caoc30255-eng/glitchscope/data/README.md

# 数据与参考结果

公开历史扫描摘要位于src/ps/workbench/samples，表示原真实记录的结果副本，不包含完整原始会话。局部波形样例仍明确保留软件推演范围。

私人评审资料中的真实会话保持原内部路径和字节，单独打包，不更名、不回写历史状态。模型训练数据及权重在src/ps/workbench/vendor/edge/data与oss等原目录；推理不自动训练。

人物图及关联恢复图/截图未放公共仓库。使用者可上传自己拥有公开权利的PNG/JPEG/WebP/BMP。当前不凭模型或算法结果替代真实采集，不把软件样例当作板卡测量。
