caoc30255-eng/glitchscope/report/llm_interactions_original/lifecycle_cases/l01.md

# 案例1 明确三板职责与图片主线

阶段：方案设计。本文件为事后导读，不替代原始对话。

## 任务与问题

截至现有记录最早的9月23日，项目已有V1基线，正在讨论波特率偏差和图片演示。单次trial只传1字节，不能直接承担完整图片流；模型一度把STM32设想成图片重组与修复端，偏离原有职责。

## 人工输入与决策

操作者提出通过UART传图、注入毛刺并显示恢复效果，指定PYNQ网页展示，纠正“STM32仅作为真实DUT”，随后明确把图片传输与自动恢复列为主线。

## 反馈与修正过程

模型重新对照工程规格与交接文档，撤回让STM32负责修图的设想，提出分块发送、真实数据回报和PS重组展示的路线；把单字节测试链与图片流需求分开。

## 验证与工程结果

形成了三板职责和新增图片主线的路线说明。该阶段讨论中的选择性重传只是当时的方案设想，不能当作最终实现；后续版本发展为接收数据择优与CRC约束修复，见图片修复案例。

## 适用范围与限制

这里记录的是可恢复历史中的方案演进，不声称恢复了项目最初立项，也不把设计讨论记为硬件验收。

## 原话节选与原消息定位

节选去除Markdown排版；未替换原始消息。

m00073 user 2026-09-23T14:29:52.940000+00:00

> 你有没有阅读项目的工程规格文档 stm32仅作为真实dut

m00074 assistant 2026-09-23T14:30:05.291000+00:00

> 读过工程规格 V1.3，但我上一条把 STM32 当成图片演示的重组与修复端来设计，偏离了“STM32 仅作为真实 DUT”的定位。我会重新对照工程规格和 9 月 23 日交接文档，按平台测试与展示的职责修正方案。

相关消息：m00061、m00069、m00073、m00074、m00075、m00078、m00089、m00091

## 工程证据入口

- formal:docs/project_overview.md

- workspace:release_artifacts/roadmap/full_project_roadmap_2026-09-23.md
