caoc30255-eng/glitchscope/report/llm_interactions_original/lifecycle_cases/p02.md

# 案例6 完善STM32实收回报与短脉冲处理

阶段：开发联调。本文件为事后导读，不替代原始对话。

## 任务与问题

STM32需要报告真实接收字节和状态，不能只回一个成功标志。固件还要处理接收活动、迟到字节及缓冲边界，避免漏采短低脉冲后过早回复OK。

## 人工输入与决策

队友操作者转交验收反馈，要求修订，随后确认新一轮任务是复验既有固件而非重写功能，保留旧版与独立修订版。

## 反馈与修正过程

队友会话记录了v0.2的串口事件缓冲、微秒计时和状态机，再根据反馈在v0.3加入PA10活动锁存、迟到字节、发送前取消和板级记录表；区分资料包、固件与协议版本。

## 验证与工程结果

R103记述ARM构建0错误0警告；R105记述协议167项、事件/ring68695项、活动模型43项断言及构建通过。这些是队友当时的报告，原测试输出未随协作包提供，本轮不将其改写为独立重验。

## 适用范围与限制

队友开发轮次明确未烧录、未改线；不能把离线固件工作当作当时已完成现场验收。STM32始终承担DUT实收与回报，不承担平台选点和图片修复。

## 原话节选与原消息定位

节选去除Markdown排版；未替换原始消息。

peer_R105_M01 user 2026-10-09T09:36:34+00:00

> 我已收到反馈文档，队友B_验收反馈与补证据.md，请查看并修改

相关消息：peer_R103_M01、peer_R103_M06、peer_R105_M01、peer_R105_M06、peer_R108_M01、peer_R108_M02

## 工程证据入口

- peer:附录/对话可见消息与操作索引.json

- peer:来源与整理说明.md
