caoc30255-eng/glitchscope/src/ps/workbench/live_integration.md

# 本版执行入口

请读“board_operations.md”。本版改为本轮父授权＋每任务执行凭据，不再要求操作者逐计划补APPROVED文件。批准动作仍由操作者在界面明确完成；程序只检查范围、保留额度和执行已确认任务。

安装、软件检查、打开网页均不授权任何新试验。此前44条并未获批。安装后需要通过本版目标软件凭据及原资源核对，再由操作者确认本轮范围和额度、逐任务确认启动。
