caoc30255-eng/glitchscope/report/design_report/README.md

# 设计报告

[设计报告](design_report.pdf)，40页，2026年11月4日协作内容补充版。

第7章新增AI建议的采纳与取舍、人工复盘心得，并关联配套Markdown协作记录。目录和页码已更新。当前核验见`../verification/design_report/review_20261104.json`；此前核验文件保留为历史凭据，其哈希不指向当前文件。

报告中的历史封存ZIP及实板会话用于定位原实验；当前仓库部署见`../../docs/first_installation.md`，构建见`../../docs/fresh_reproduction.md`。本次仅更新文档，不新增硬件试验。
