caoc30255-eng/glitchscope/report/llm_interactions_original/README.md

本目录为公开投影：Markdown为当前阅读版，26页PDF作为历史版本保留；Word原稿不随公开仓库分发。案例及来源索引中的本地账户前缀已经匿名化。历史完整原件保留于独立私有评审资料，详见docs/public_release.md。

# 大模型协作记录 当前提交版

- [Markdown当前版](llm_collaboration_with_v1.md)
- [历史PDF版](llm_collaboration_with_v1.pdf)
- [Word编辑版](私有可编辑原稿)

当前Markdown保留22案例，并补充AI协助、人工采纳与未采纳方案及复盘心得。历史PDF为26页、22案例：V1早期6例加后续四阶段16例，历史工作范围为2026年9月8日至11月1日。历史PDF采用宋体黑白排版。

## 来源与索引

v1_cases/和v1_source_map.json记录V1案例及其来源；lifecycle_cases/和lifecycle_source_map.json关联后续16案例。index.json与cases/是主线原文归档的任务索引及原六案例导读，属于来源资料，不是另一版正式阅读文档。

主线原包submission_evidence/llm_interactions_20261101.zip与队友原包teammate_llm_interactions_20261101.zip均保持原样。完整评审资料包为submission_evidence/llm_collaboration_final_20261101.zip，含当前文档、两个原包、V1缓存和日志。

V1有7份有界缓存、35条片段及9份工程资料，不声称早期聊天完整恢复；截断、日期和模型版本缺口按来源保留。主线4750条与队友739条分别统计，不相加当作去重消息总数。

旧8页、19页文档及对应历史发布包已移出当前交付目录，保存在桌面GLITCHSCOPE_历史备份中。原始对话、证据、索引、当前26页全文未删除。设计报告已于2026-11-02完成独立复核并加入report/design_report；本目录保留原始协作记录及当前阅读版。
