caoc30255-eng/glitchscope/docs/design_report_integration_20261102.md

# 设计报告合入记录

2026-11-02按用户要求对自行导出的PDF再次审阅，通过后加入工程。检查覆盖架构职责、三项功能输入与输出、CRC候选及完整性条件、统一d/s排名、实验对照与比例、时钟和资源口径、部署复现及原件索引，并逐页检查39页。

正式入口为`report/design_report/design_report.pdf`，复核凭据为`report/verification/design_report/review_20261102.json`。本次仅修正PDF隐藏Subject中的旧组别标签，未重新排版或修改正文。

根目录README原先将两组配对结果称为局部位错，现按原始审查记录改为B完整帧累计位错，与设计报告一致。

发布清单同步本次文档变更，原始来源清单、硬件会话、通过凭据和旧封存ZIP不重签、不改名。报告第9章中的源码ZIP及SHA仍用于定位之前封存的软件快照。新增含报告工程包与该软件快照分别保留。
