caoc30255-eng/glitchscope/report/llm_interactions_original/llm_collaboration_with_v1.md

# 嵌入式通信容错测评平台大模型协作记录

本记录说明AI在方案设计、开发联调、功能验证和交付复现中提供了哪些帮助，哪些建议被采纳、修改或撤回，以及人工如何依据工程证据作出决定。正文由原有协作资料整理，不是重新生成的聊天实录。

历史案例覆盖2026年9月8日至11月1日，共22例，其中V1早期6例、后续四阶段16例。本版于2026年11月4日整理为Markdown。原消息编号和来源标识继续保留；既有PDF及原始资料不被这次整理改写。

## 1 协作分工与阅读说明

人工确定用途、板卡职责、试验范围与验收要求，进行接线、上电、烧录、板端操作和结果回传。AI协助梳理接口、提出实现方案、编写和审查代码、构造反例、分析日志、组织文档。建议经脚本、仿真、板端运行或原件复核后，才能形成对应范围的结论。

下文把三类内容分开：**采纳或修订后采用**是最终工程处理；**未采纳或撤回**是记录中确有的方案调整；**未作出的结论**是证据范围限制，不冒充一条曾被提出又被否决的建议。早期材料不足以恢复逐轮讨论的地方，保留“未恢复”的状态。

“人工复盘心得”依据已记录的人工纠正、取舍与验证过程浓缩整理，属于事后总结，不作为成员逐字发言。文中的AI开发协助与平台内的边缘AI选点功能是两回事；后者本身还需要独立验证。

## 2 AI协助与人工取舍要点

| 协作问题 | 采取的做法 | 没有采取或撤回的做法 | 判断依据 |
|---|---|---|---|
| 图片功能职责 | STM32保持独立DUT，PS完成重组与修复 | 撤回让STM32承担图片修复的初始设想 | l01，m00073、m00074 |
| 回报长度契约 | 身份、窗口和容量先锁定，长度由回报头派生并以CRC复核 | 修订按请求长度固定登记回报长度的草案 | l02，合法短错误回报反例 |
| 长回复接收 | 依据溢出记录转向原生接收服务并核对调度设置 | 撤回仅靠已有Python/线程优化就已稳定解决的判断 | l05，失败记录与板端压力回传 |
| 统一d/s分析 | 比较本次实际波形的共同有效窗口，整图统一参数 | 未采用上一块反馈预测独立扰动、读取已知注入计划代替接收分析的思路；人工决定此功能不使用AI | l08，m03082至m03893相关记录 |
| 时钟解释 | 核对参考频率、PLL及分频，修正显示值的解释 | 修正直接把PYNQ显示150MHz作为实际工作条件的前提 | l11，7020与AX7010回传 |
| 局部波形候选 | 支持实际N/64个共同窗口，列出未参与块 | 修订只有完整64块才能提供参考的旧规则，不把63写死 | l12，m04701等 |

其他重要处理包括恢复冻结模型原始字节、仅对ARM浮点评分和熵使用有界容差、分别保存新旧SD会话。它们说明人工如何限定修复范围；不据此虚构“AI曾建议取消所有校验”的对话。

## 3 人工复盘心得

**先明确设备职责，再讨论算法。** 模型可能提出功能上可行却偏离项目目标的方案。STM32只承担真实DUT的人工纠正，使平台分析与被测行为保持分离，也避免把修复能力归到被测设备上。

**反例比一段顺畅的解释更有用。** 合法短回报揭示了协议长度假设的冲突；溢出位和原始字节促使接收实现继续改进。请求AI审查时，应同时给出输入、预期、失败原件和约束，而不只描述“运行不正常”。

**先检查前提，再增加实现复杂度。** 时钟问题中，人工提出100MHz的可能性，推动核对参考源和分频。软件读数的单位正确，并不意味着计算前提正确。应先解释现有配置，再决定是否修改RTL或系统。

**修复要对准出错层级。** 换行改变属于发布字节问题，浮点末位差异属于数值兼容问题，现场连线问题需要实物处理。恢复文件、设置有限数值容差、固定接线分别解决不同问题，不能用一个宽松的“通过”条件代替。

**部分有效证据应保留用途，也保留边界。** N/64局部窗口可以支持同窗口候选比较，但不能覆盖缺失块。规则和AI的稀疏选点能减少记录数，仍应同时给出覆盖范围。比较前先统一分母，比给方法贴上“更优”的标签更重要。

**失败记录是下一轮判断的输入。** 新旧卡对照、读回顺序检查和固线后复验形成了定位过程。保留目录、版本、会话身份和失败状态，才能知道改善来自哪里，也能避免把不同轮次的成功拼成一次验收。

**把已验证的方法沉淀为工具，而不是把一次成功泛化成保证。** 跨版本接口适配、冻结文件检查和模型一致性检查可抽成技能。工具的适用设备、输入与验证层级仍需要写明，模型生成的说明本身不构成验证。

## 4 V1基线开发案例

V1部分来自7份有界缓存、35条片段与9份工程资料。材料能够说明阶段设计、失败和交接，但不能恢复全部原始提示词及每次代码修改；以下不为每例补造采纳或否决对话。

### v1_01 共享接收前端与核心验证边界

历史日期：2026-09-08。

**任务与设计决定。** 早期A、B各自同步同一异步输入，可能因两条同步链形成不同的数字观测。9月8日缓存中的日志摘要记载，改为共享两级RX前端，并让接收器使用已同步输入，使算法比较基于同一数字信号。

**开发与协作过程。** 操作者在CRC测试后要求生成工程日志；缓存保留了当日助手整理的共享前端、Trial集成、ABORT/CLEANUP、配置校验和综合路线。该缓存不是完整开发聊天，不能据此补写没有恢复的逐轮代码修改。

**当时记录的结果。** 缓存摘要记载共享前端后重新检查帧间配置锁存和代表性故障条件；9月14日V1.0交接文档随后把UART PHY至结果生命周期列为冻结基线。这两个来源分别表示阶段工作与后续交接，不是本轮重新验证。

**结论边界。** 共享同步链不会消除亚稳态；数字行为回归不能单独证明跨板电气、完整实现时序或后续STM32链路已经通过。V1时A/B位于7010，后续迁到7020的过程见原案例5。

**协作取舍的可恢复程度。** 本例按现存缓存或工程日志陈述已记录处理；未恢复的AI建议、人工否决与逐轮修改不补写。

**来源定位：** cached:v1_20260908_01_02；document:d07。

### v1_02 从控制UART仿真到双板字节回环

历史日期：2026-09-08 至 2026-09-10。

**任务与问题。** 核心仿真通过之后，仍需要真实控制接口把PYNQ与AX7010连接。PHY收发、CRC和完整命令协议不是同一个层级，必须分别建立可观察的验证节点。

**人工反馈与推进。** 9月8日缓存保留CRC测试输出片段；9月9日日志记载首次AX7010 Smoke Test只证明时钟、复位和LED心跳，完整控制协议尚未实测。9月10日再打通PYNQ、AXI UARTLite、物理连线、7010 Echo与返回链。

**可恢复的原始片段。** 9月10日用户缓存原话含“TX 0x00 -> RX 0x00  PASS”，并列出0x55、0xAA、0xFF、0xA5和0x5A全部匹配，最后为“BYTE PATTERN TEST: PASS”。这些是缓存中的用户可见回传，仍保留其不完整性。

**记录结果与范围。** 9月10日工程日志将该轮记为HW-UART-02双板PHY通过。它证明已测试位型的回环，不等于后续Parser、配置、START、结果邮箱和全部异常都在这一天完成。当前整理没有重跑串口。

**协作取舍的可恢复程度。** 本例按现存缓存或工程日志陈述已记录处理；未恢复的AI建议、人工否决与逐轮修改不补写。

**来源定位：** cached:v1_20260908_01_01；cached:v1_20260910_04_01；document:d01；document:log0910。

### v1_03 配置隔离与重复ABORT生命周期修复

历史日期：2026-09-11 至 2026-09-14。

**任务与问题。** 协议必须保证在途配置不被覆盖、重复命令具有确定行为、RESULT_ACK真正清理邮箱。单看收到ACK不足以证明生命周期正确；前置状态错误也不能当作产品失败。

**开发与修正。** 9月11日日志记录Validator正反边界和BUSY期间Apply拒绝。9月12日日志进一步记载repeated ABORT缺陷：中止保持使Guard选到陈旧运行ID，且已有结果阻断幂等ABORT；修复为使用冻结的中止ID，并允许中止锁存态进入幂等路径。

**结果与证据层次。** 9月12日日志记录修复后07C幂等响应与07D清理后重启通过，同时保留08A仅完成前置检查的停点。9月14日缓存则保留第二次RESULT_ACK收到NO_RESULT的用户回传；同日V1.0交接文档记录协议层冻结。

**结论边界。** 本轮核对的是旧缓存和工程日志，不是重新签发当年的RTL、时序或板测结论。9月12日“未完成邮箱验证”和9月14日“协议冻结”是按时间推进的不同状态，不能彼此覆盖。

**协作取舍的可恢复程度。** 本例按现存缓存或工程日志陈述已记录处理；未恢复的AI建议、人工否决与逐轮修改不补写。

**来源定位：** cached:v1_20260911_05_03；cached:v1_20260914_07_03；document:d02；document:d03；document:d07。

### v1_04 十四候选筛选与H2预封存验证

历史日期：2026-09-15 至 2026-09-16。

**任务与问题。** 在14组合法d/s中选择较优配置，不能只挑单个有利坐标。基础25点网格中9组候选并列全通过，需要在同预算下增加有区分力的条件，同时满足正常通信和延迟约束。

**当时的工作路线。** 9月15日日志记录宽毛刺压力切片、多phase压力网格和反向候选顺序重放；协议和接收器RTL保持不变，以testbench推进候选比较。最终在36个去重数字坐标上锁定d4/s-1，增量延迟180ns，满足不超过210ns的约束。

**独立验证记录。** 锁定后、读取结果前封存27个H2坐标及CSV哈希。9月16日日志记载H2-V1中B*为27/27、A为18/27；这些数字对应当时数字验证条件，不是后来STM32实板成功率，也不是当前图片统一参数d4/s-2的证据。

**来源与结论边界。** 本例依据两份现存开发日志；未恢复该阶段完整原始聊天，不把日志改写成逐字对话。H2结果不能回流调参；旧B*只在其冻结条件内成立，不能直接迁到另一块板或另一类载荷上宣布最优。

**协作取舍的可恢复程度。** 本例按现存缓存或工程日志陈述已记录处理；未恢复的AI建议、人工否决与逐轮修改不补写。

**来源定位：** document:d04；document:d05。

### v1_05 Raw Snapshot从参考测试到AXI与BRAM

历史日期：2026-09-16 至 2026-09-17。

**任务与实现。** 7020需要保存真实输入波形，而不是只依赖发送参数。早期按核心采样、同步触发前端、集成、AXI访问、OOC综合，再扩到4096点正式窗口的顺序推进。

**失败反馈与修正。** 9月16日日志记载CAP-01首轮24个错误来自testbench任务之间多出的采样边沿，判INVALID后修正测试台；9月17日CAP-06B首次脚本在不兼容Tcl命令处停止，BRAM已推断也不能把整项记为PASS。

**当时记录的结果。** 正式窗口为2048点Pre、1点触发、2047点Post；验证环形回绕、全逻辑索引和12位AXI地址，保留旧低地址寄存器兼容。日志还记录Block Design接入、完整综合与FCLK BUFG结构修正。

**结论边界。** 9月17日停点仍是板级输入引脚和接线确认，未完成Implementation和实板采样。不能用该日综合WNS或BRAM推断替代后续实际实现；名义100MHz时间换算也要结合后期时钟核对说明阅读。

**协作取舍的可恢复程度。** 本例按现存缓存或工程日志陈述已记录处理；未恢复的AI建议、人工否决与逐轮修改不补写。

**来源定位：** document:d05；document:d06。

### v1_06 首次双板受扰采样与三次重复

历史日期：2026-09-18。

**任务与衔接。** 在采样核心、AXI和构建完成后，V1.1交接把开发推进到双板物理输出、FAULT_MARK触发和PYNQ读回。此时STM32真实DUT仍未开始，不能把这条双FPGA链路写成三板整图功能已完成。

**现存交接记录。** 9月18日文档记载同一受扰条件下A得到0x5D而B*得到0x55；Raw Snapshot保存4096点、触发偏移2048、FAULT_MARK高电平100点，trial9110、9111、9112三次重复一致，Errors为0。

**对后续开发的意义。** 该记录把设定扰动、内部接收差异与板侧数字采样关联起来，形成进入独立STM32阶段的历史基础。后续控制链诊断、接收器迁移、图片流和新卡复现都是在此基础上扩展，而非V1本来就具备的能力。

**来源与结论边界。** 本例仅有现存交接文档作为整理依据，本次没有重新取得这三次采样的全部原始文件。文档中的PYNQ150MHz读回保留为历史描述，并以当前时钟参考审计解释；不能据此宣称真实150MHz签核。

**协作取舍的可恢复程度。** 本例按现存缓存或工程日志陈述已记录处理；未恢复的AI建议、人工否决与逐轮修改不补写。

**来源定位：** document:d08。

## 5 方案设计阶段协作案例

### l01 明确三板职责与图片主线

**问题与原假设。** 截至现有记录最早的9月23日，项目已有V1基线，正在讨论波特率偏差和图片演示。单次trial只传1字节，不能直接承担完整图片流；模型一度把STM32设想成图片重组与修复端，偏离原有职责。

**人工输入与决策。** 操作者提出通过UART传图、注入毛刺并显示恢复效果，指定PYNQ网页展示，纠正“STM32仅作为真实DUT”，随后明确把图片传输与自动恢复列为主线。

**AI协助与采纳后的修订。** 模型重新对照工程规格与交接文档，撤回让STM32负责修图的设想，提出分块发送、真实数据回报和PS重组展示的路线；把单字节测试链与图片流需求分开。

**记录结果。** 形成了三板职责和新增图片主线的路线说明。该阶段讨论中的选择性重传只是当时的方案设想，不能当作最终实现；后续版本发展为接收数据择优与CRC约束修复，见l06。

**未作出的结论与证据范围。** 这里记录的是可恢复历史中的方案演进，不声称恢复了项目最初立项，也不把设计讨论记为硬件验收。

**原消息定位：** m00061、m00069、m00073、m00074、m00075、m00078、m00089、m00091。

**工程证据入口：**

- `formal:docs/project_overview.md`
- `workspace:release_artifacts/roadmap/full_project_roadmap_2026-09-23.md`

### l02 用短回报反例修正图片协议契约

**问题与原假设。** 图片协议草案要求首字节前登记精确回报长度，却又允许STM32报告少于请求长度的实收数据。正常软件回归通过，仍不能排除契约本身的矛盾。

**人工输入与决策。** 操作者将队友交付和反馈带入主线复核。模型核对同版文件与哈希，区分代码修复通过、协议冻结和实板验证三个不同状态。

**AI协助与采纳后的修订。** 构造请求64字节、实际实收为0的合法20字节错误回报：完整CRC与身份可以成立，但按请求长度84字节登记的捕获器把它当作SHORT_FRAME。由此改为先锁定身份、窗口和最大容量，再从回报头派生长度并经完整CRC复核。

**记录结果。** 形成明确的软件反例、修订方向及新版本复验要求。这个案例体现模型协作不仅生成代码，也用于检查接口假设是否相容。

**未作出的结论与证据范围。** 该轮是离线协议与参考模型评审，不代表AXI时钟级行为、RTL或实板已经通过；合法错误回报也不能因业务失败就被当作传输截断丢弃。

**原消息定位：** m00230、m00232、m00245、m00319、m00320。

**工程证据入口：**

- `workspace:release_artifacts/reviews/image_stream_v0_6_3_acceptance_2026-09-29.md`
- `workspace:release_artifacts/design/image_stream_v0_6/contract.md`

## 6 开发联调阶段协作案例

### l03 固化控制链原始字节与溢出诊断

**问题与原假设。** 早期一条试验缺少内部结果，历史现场没有完整控制UART原始字节和错误位，不能仅凭后续正常ACK确定原因。需要先让后续故障可留证。

**人工输入与决策。** 操作者封存正在使用的Notebook，将诊断模块装入同一内核，依次执行正常试验、受控读取停顿与恢复试验，并回传结果。

**AI协助与采纳后的修订。** 模型将临时诊断固化成版本化PYNQ模块，按阶段保存原始收包及状态。受控停顿1.5ms后，trial13023捕获0x22和溢出位0x20；即使STM32载荷正确，该次仍记INVALID。

**记录结果。** 9月24日归档记录确认13022正常、13023异常证据捕获、13024恢复。新增诊断能力没有改写旧网格，也没有把有DUT回报等同于完整事务有效。

**未作出的结论与证据范围。** 这是故障记录与分类能力，不保证Python轮询永不溢出；也不能用新反例倒推出旧缺失记录的唯一根因。

**原消息定位：** m00094、m00107、m00115、m00116、m00117、m00118、m00124。

**工程证据入口：**

- `workspace:release_artifacts/evidence/control_rx_m0/m0_control_rx_acceptance_2026-09-24.md`
- `workspace:release_artifacts/evidence/control_rx_m0/m0_control_rx_acceptance_2026-09-24.json`

### l04 按模块验证波特率偏差与零偏差兼容

**问题与原假设。** 控制协议已定义有符号波特率偏差，但旧Decoder和发送器未完整接入。直接修改共用发送器可能影响控制UART，单字节观察也可能掩盖很小的频偏。

**人工输入与决策。** 操作者按步骤创建RTL与测试台，在Vivado运行隔离仿真并回传PASS和失败信息。模型核对用户创建的文件与实际仿真副本哈希。

**AI协助与采纳后的修订。** 从位时钟、原子配置、Decoder到连续十字节发送器逐层验证。code=0保持旧路径；跨帧累计NCO相位，增加±0.1%、±2%、±8%六点及边界拒绝。再单独检查payload旁路，避免把其他字节送入A/B。

**记录结果。** 隔离发送器的内容、CRC和整帧时钟数匹配参考；payload观察在±0.1%时分别表现为999和1001个时钟。验证从“文件看起来正确”推进到可观察的时序差异。

**未作出的结论与证据范围。** 本案例引用的PASS限于对应隔离模块与测试输入，不能扩写为当时整板、所有故障组合或当前发行固件的完整验收。

**原消息定位：** m00132、m00136、m00151、m00158、m00160、m00162、m00163、m00178。

**工程证据入口：**

- `workspace:release_artifacts/design/faultstim_v2_1/evidence/m1c_frame_tx_acceptance_2026-09-24.md`
- `workspace:release_artifacts/design/faultstim_v2_1/evidence/m1c_payload_tap_acceptance_2026-09-24.md`

### l05 从轮询溢出推进到原生实时接收服务

**问题与原假设。** 长回复超过UARTLite小FIFO的及时服务能力。Python优化、后台线程及共享接收修订后仍有溢出；发送停顿也暴露了Linux调度与命令超时之间的不匹配。

**人工输入与决策。** 操作者回传错误位、FIFO残留、线程权限与板端运行统计，保留失败会话，再编译独立原生库和运行新会话。

**AI协助与采纳后的修订。** 模型依据新增诊断撤回“已稳定解决”的过早判断，先改交易线程共享搬运，再增加CPU亲和性、实时优先级、优先级继承锁与短暂空闲休眠。启动先读回调度设置，失败时不静默降级。

**记录结果。** 10月16日回传1000次远端只读交易全部通过，最大交易内接收服务间隔约0.165ms；随后CONFIG和首个256字节ITEM完成真实回传、核验与严格退役。

**未作出的结论与证据范围。** 普通内存调度验证、只读交易压力与真实ITEM是三个层级；有限压力结果不构成普通Linux永不丢字节的保证。旧溢出会话没有自动恢复。

**原消息定位：** m01346、m01444、m01448、m01519、m01776、m01778、m01779、m01799、m01801、m01803、m01805。

**工程证据入口：**

- `workspace:PS_UART_RT_v5_2026-10-15/README_先读.md`
- `formal:src/ps/native/uartlite_service_v5.c`

### p01 迁移已有接收器并验证7020数字顶层

**问题与原假设。** 队友接手时需要区分重新设计A/B算法与迁移已有实现。旧7010通过的配置不能直接视为7020上的最优参数，隔离模块通过也不等于完整PS系统可运行。

**人工输入与决策。** 队友操作者明确询问是重做还是验证后迁移，并要求先完成数字集成。该需求通过独立队友会话记录，而非主线模型代述。

**AI协助与采纳后的修订。** 队友会话中的模型以7010固定A和可调三点表决B为基线，适配共享CH0同步前端、配置与读回，连接帧关联和Gateway数字发送原型，并单独说明完整Block Design和实体链路边界。

**记录结果。** 队友R021记述Vivado2018.3联合仿真4组场景、309项检查及独立综合通过，覆盖正常发送、A译错后如实转发、选择B和身份受扰拒绝。此次纳入的是可见协作记录，未重新执行该历史仿真。

**未作出的结论与证据范围。** 这是早期单字节数字顶层的迁移过程，不能据此把Gateway实体链路、图片FIFO或最终整机一并标为当时已验收。原F盘源码与完整构建日志不在本次记录包中。

**原消息定位：** peer_R018_M01、peer_R018_M02、peer_R021_M01、peer_R021_M04。

**工程证据入口：**

- `peer:附录/对话可见消息与操作索引.json`
- `peer:完整协作记录.md`

### p02 完善STM32实收回报与短脉冲处理

**问题与原假设。** STM32需要报告真实接收字节和状态，不能只回一个成功标志。固件还要处理接收活动、迟到字节及缓冲边界，避免漏采短低脉冲后过早回复OK。

**人工输入与决策。** 队友操作者转交验收反馈，要求修订，随后确认新一轮任务是复验既有固件而非重写功能，保留旧版与独立修订版。

**AI协助与采纳后的修订。** 队友会话记录了v0.2的串口事件缓冲、微秒计时和状态机，再根据反馈在v0.3加入PA10活动锁存、迟到字节、发送前取消和板级记录表；区分资料包、固件与协议版本。

**记录结果。** R103记述ARM构建0错误0警告；R105记述协议167项、事件/ring68695项、活动模型43项断言及构建通过。这些是队友当时的报告，原测试输出未随协作包提供，本轮不将其改写为独立重验。

**未作出的结论与证据范围。** 队友开发轮次明确未烧录、未改线；不能把离线固件工作当作当时已完成现场验收。STM32始终承担DUT实收与回报，不承担平台选点和图片修复。

**原消息定位：** peer_R103_M01、peer_R103_M06、peer_R105_M01、peer_R105_M06、peer_R108_M01、peer_R108_M02。

**工程证据入口：**

- `peer:附录/对话可见消息与操作索引.json`
- `peer:来源与整理说明.md`

## 7 功能验证阶段协作案例

### l06 用实际受损图片验证CRC约束修复

**问题与原假设。** 图片功能必须先证明展示的是实际接收的坏图，再证明修复来自接收数据计算。不能把发送原图覆盖到结果上，也不能把CRC检错本身说成纠错算法。

**人工输入与决策。** 操作者执行整图会话并交回原件。模型先核验受损图来源，再独立重建修复结果，分列B接收图与STM32回报。

**AI协助与采纳后的修订。** 保留CRC失败的数据，使用块CRC约束搜索及多路接收择优，按整图SHA验证精确恢复。早期方案中的重传设想没有被偷换为已经实现的功能；本次恢复依据保存的接收原件重算。

**记录结果。** 10月19日session27核验记录含65次START、DONE及严格退役，实际毛刺计数8394。单B修复剩483个错误像素，多路融合结果为0且SHA匹配；这是一组有实收来源的功能证据。

**未作出的结论与证据范围。** CRC匹配候选不等于唯一原文，整图SHA一致才支撑该次精确恢复。单张图片通过不代表任意损伤都能修复，也不说明STM32硬件接收本身被调优。

**原消息定位：** m02378、m02379、m02515、m02635、m02636。

**工程证据入口：**

- `workspace:release_artifacts/reviews/random_image_session_00000024_2026-10-18/核验结论.md`
- `formal:report/verification/workbench_repair/repair_delivery_review.json`
- `formal:report/verification/workbench_repair/actual_raw_contract.json`

### l07 从模拟网格走到真实容错热力图

**问题与原假设。** 界面能显示14格或模型流程完成，不代表硬件边界已经测出。还需要区分B整帧正确、STM载荷正确与STM业务成功。

**人工输入与决策。** 操作者按受控计划执行新会话并提供完整证据。模型先在软件层验证预算、异常停止与原件篡改拒绝，再检查板端记录。

**AI协助与采纳后的修订。** 计划采用CONFIG与无扰动参照各1条、14格各3次，共44条。逐条核对参数读回、42次毛刺快照、原始接收结果和退役证明，再独立重算三类统计。

**记录结果。** 10月20日session29的44条完成严格退役，无UNKNOWN；三类统计与网页一致。B在相位15、宽度10出现2/3正确，STM某些格点载荷正确却业务失败，证实不能合并判据。

**未作出的结论与证据范围。** 每格3次属于粗扫描，混合结果需要保留；少量重复不是确定边界或普遍概率保证。44条是这份配置的计算结果，不是所有扫描的固定条数。

**原消息定位：** m02561、m02640、m02642、m02643、m02701、m02703、m02705、m02706。

**工程证据入口：**

- `workspace:release_artifacts/reviews/session29_real_scan_2026-10-20/核验结论与下一步.md`
- `workspace:STM_B_Real_Heatmaps_Baseline_2026-10-21/实测基准报告.md`
- `formal:report/verification/scan_backend/owner_review.json`

### l08 把参数推荐限定为同波形的可验证比较

**问题与原假设。** 模型先后提出利用上一块反馈或已知毛刺计划选参，但独立随机扰动不能由上一块预测，读取注入计划也不符合未知干扰接收的目标。局部快照又不等于完整帧波形。

**人工输入与决策。** 操作者要求分析本次实际波形，明确采用软件推演，并决定第三功能不使用AI。后续统一参数用于64块，不允许每块各取一组d/s。

**AI协助与采纳后的修订。** 转向与B接收器一致的逐周期软件模型，保留初相歧义，比较同一组有效窗口中的14组d/s。31段早期波形中21段一致、10段不确定，没有用目标答案反选初相；再由操作者运行RTL对照。

**记录结果。** 10月22日回传1125用例、11389950周期对照通过。后续两张图片四组260条独立配对验收中，统一d4/s-2相较基线减少位错约30.3%和35.4%，保留具体条件与原件关联。

**未作出的结论与证据范围。** 模型与RTL一致不能补回采集时缺失的内部初相；软件候选、局部范围和重新实测的参数效果分层报告，不宣称全条件最优，也不改写原接收数据。

**原消息定位：** m03082、m03086、m03158、m03162、m03163、m03165、m03171、m03201、m03202、m03893。

**工程证据入口：**

- `formal:src/ps/workbench/vendor/ds/rtl_cosim_receipt.json`
- `formal:report/verification/ds_analysis/owner_acceptance.json`

### l09 验收边缘AI的运行闭环与选点范围

**问题与原假设。** 模型能推理、跨平台输出一致、闭环能选点，以及是否比规则更省试次，是不同的验证问题。不能把开源组件接入或软件测试通过直接等同于扫描提效。

**人工输入与决策。** 操作者要求覆盖自选配置，执行ARM软件检查与三组实板对照，交回失败和修复后的报告。模型根据这些结果限定已学习范围和回退规则。

**AI协助与采纳后的修订。** 对ARM浮点末位误差，只给score与entropy指定1e-12绝对容差，类别、动作和权限严格比较，模型权重不改；45条黄金查询和450条C对照通过。随后按14条规则、14条AI、44条参照执行有界对照。

**记录结果。** 三组共72条流程完成；规则和AI各测4格，均触及新参照6个边界格点中的2格，主要覆盖指标持平。项目保留二者作为减少选点的并列策略，不要求AI优于规则才允许使用。

**未作出的结论与证据范围。** 本轮确认推理、选点、反馈与证据链可运行，不支持AI普遍更快、更准或所有自选条件均经实板验证。完整14格图来自参照组，不能将稀疏选点展示成全网格实测。

**原消息定位：** m03904、m03908、m03913、m03962、m03964、m03966、m03990、m03994、m03995、m03996、m03997。

**工程证据入口：**

- `formal:report/verification/edgeai_arm/owner_review.json`
- `formal:report/verification/edgeai/owner_final_comparison.json`
- `formal:docs/selection_methods.md`

## 8 交付复现阶段协作案例

### l10 把外部评审转化为Skill缺陷修订

**问题与原假设。** 86项原测试通过后，另一次上下文评审仍发现零掩码身份校验、时钟副作用记录、混合寄存器字段语义和新仿真示例闭环不足。

**人工输入与决策。** 操作者将评审意见带回主线并要求集中修订。模型逐项核对并复现，不把外部评分当作自动证明，也不直接把评审文字当作实现要求。

**AI协助与采纳后的修订。** 补零掩码拒绝、HWH地址核对、字段级访问语义、流式哈希与Python/C示例，运行新RTL示例及负向验证，并区分真实适配和合成测试范围。

**记录结果。** 修订与验证资料进入正式Skill目录；随后加入时钟审计能力，当前归档保留195项回归和各阶段原件。评审推动了实现与自动检查，而不仅是说明文字扩充。

**未作出的结论与证据范围。** 独立评审会话同样属于模型协作，不冒充人类评委意见。回归测试、现场跨板结论和具备原始日志的实测分别记录来源。

**原消息定位：** m04298、m04299、m04300、m04301、m04303、m04304、m04305。

**工程证据入口：**

- `formal:skill/verification/current_summary.json`
- `formal:skill/verification/current_unit_report.json`
- `formal:skill/verification/cross_board_experiment.json`

### l11 核对名义频率与板载参考时钟

**问题与原假设。** PYNQ显示FCLK0为150MHz，但150MHz时序签核没有通过。若不核对参考频率，可能把软件计算读回误当成实际配置频率。

**人工输入与决策。** 操作者提出实际可能仍为100MHz，并回传7020只读寄存器、设备树及AX7010的PYNQ2.4环境结果。

**AI协助与采纳后的修订。** 模型转向检查PYNQ的50MHz参考假设与板侧约33.333333MHz声明，结合PLL倍频30和两级分频5、2推导；同时修复采集器对旧版类方法接口的兼容性。

**记录结果。** 配置推导支持当前FCLK0约100MHz；正式文档区分PYNQ名义150读回与参考加寄存器推导。没有仅为读数名称修改setter或制造150MHz签核通过结论。

**未作出的结论与证据范围。** 这是参考与配置一致性审计。当前发行说明依据实际交付范围和100MHz时序结果，不将软件读回当作完整硬件身份或频率证明。

**原消息定位：** m04343、m04362、m04363、m04400、m04422、m04423。

**工程证据入口：**

- `formal:docs/clock_reference.md`
- `formal:report/verification/clock_reference/board_readonly_excerpt.json`
- `formal:skill/pynq-clock-reference-audit/SKILL.md`

### l12 修复冻结文件并保留部分证据的用途

**问题与原假设。** 工作台分析在FROZEN_CYCLE_MODEL_CHANGED处被拦截；恢复原模型后，另有1块局部波形无法对齐，原全64规则不能给出完整候选。两类问题需要分别处理。

**人工输入与决策。** 操作者提供报错包，要求修复网页，并进一步要求局部参考支持任意实际有效数量，不能写死63块；同时指定覆盖率、未参与块与大字号提示。

**AI协助与采纳后的修订。** 模型对照原冻结凭据，发现CRLF/LF换行差异，恢复原字节而不改凭据绕过。随后新增共同有效窗口比较：14组候选使用同一组窗口，局部参考与全64候选分开。

**记录结果。** 模型哈希重新匹配既有RTL凭据，网页与worker链路恢复。有效窗口1至64块可给局部参考；0块或完整性、模型矛盾时不出候选，界面明确列出N/64覆盖和未参与块。

**未作出的结论与证据范围。** 局部参考不覆盖未评估块，不代表整图最优或推荐参数已实板验证。修复打包字节与解释数据覆盖范围，不等于放宽采集真实性校验。

**原消息定位：** m04684、m04686、m04688、m04689、m04699、m04701、m04702、m04706、m04707。

**工程证据入口：**

- `formal:src/ps/workbench/tests_ds_frozen_model.py`
- `formal:src/ps/workbench/vendor/ds/tests_local_reference.py`
- `formal:docs/ui_update_20261101.md`

### l13 备用SD冷启动与真实记录复现

**问题与原假设。** 已有安装能够运行不能代替干净环境首次部署。备用卡复现还出现图片波形异常，必须区分源码迁移、运行环境、采集读回和现场连接等可能原因。

**人工输入与决策。** 操作者从备用7020镜像启动，执行软件复现、编译原生库及0历史初始化，提供新旧卡对照、快照和最终成功会话；现场重新固定接线。

**AI协助与采纳后的修订。** 模型保留失败会话与UNKNOWN，核对多次读回和旧卡复现，撤回仅凭新卡或相位解释问题的判断。固线后重新核验未放宽的波形校验，再把通过的分支与部署说明合入发行包。

**记录结果。** fresh_runs/session7完整原件3067文件归档核验，65条严格退役、64份毛刺波形检查通过；多路CRC修复整图SHA一致，64/64局部窗口在ARM完成分析，统一软件候选d4/s-2。初始会话、试验记录与额度均为0。

**未作出的结论与证据范围。** 备用卡现场启动与初始化来自操作者回传，session7原件单独核验；不把旧卡成功冒充fresh_runs。固线后的成功支持现场判断，但不能扩写成独立电气因果测量；该次软件候选也不等于所有条件最优。

**原消息定位：** m04567、m04568、m04574、m04576、m04577、m04626、m04673、m04676、m04720。

**工程证据入口：**

- `formal:docs/first_installation.md`
- `formal:docs/fresh_sd_acceptance_20261101.md`
- `formal:report/verification/ui_software/fresh_sd_session7_20261101.json`

### p03 从UI审批原型到可演示的交互要求

**问题与原假设。** 功能后端与演示界面由不同工作线推进，不能把独立UI演示当作已经连通硬件的工作台。初版图片滑块固定两侧来源，也不满足自由比较要求。

**人工输入与决策。** 队友操作者传达完整三功能设计要求，转交左右自由选图反馈，又要求三条波形作为主要演示。主线随后提出导航字号、AI并入扫描和d/s页样式统一的修改。

**AI协助与采纳后的修订。** 队友原型补左右独立选图、交换、滑块位置、差异重算与软件重建曲线，按新版本保留；主线接手后继续做服务接口与原生d/s视图的集成检查。

**记录结果。** R175至R178可追溯7页审批稿、自由选图修订、三波形与展示版迭代；主线m04019记录UI代码与接口检查。两条记录共同说明设计输入、反馈、修订到集成的交接，而非一个模型独自完成所有环节。

**未作出的结论与证据范围。** 队友原型数据标为UI演示、未接硬件；主线软件集成也不替代后续实板验收。绿色曲线为软件重建，不称为再次实际发送的电气波形。

**原消息定位：** peer_R175_M01、peer_R175_M09、peer_R176_M01、peer_R176_M05、peer_R177_M01、peer_R177_M05、peer_R178_M12、m04013、m04019。

**工程证据入口：**

- `peer:附录/对话可见消息与操作索引.json`
- `formal:src/ps/workbench/verification_record.json`

## 9 来源范围与复核方法

原主线索引为4750条可见用户与助手消息，工具事件另存；协作方资料另列2条对话、179轮、739条可见消息。两路统计不相加冒充去重后的消息总数。没有记录的模型型号、提示词或时间不作补填。

本记录沿用工程目录`report/llm_interactions_original/`中的`v1_source_map.json`、`lifecycle_source_map.json`及案例导读。`m`编号对应主线原消息，`peer_R…_M…`对应协作方轮次与消息；`cached:`与`document:`标识V1缓存及工程文件。原始消息和完整附件按既有独立评审资料归档，不因Markdown正文中的定位编号而被视为已全部公开。

证据入口的`formal:`表示正式工程相对位置，`workspace:`表示历史工作区资料，`peer:`表示协作方原包内位置；这些是来源标识，并非本Markdown所在目录下可以直接点击的路径。定位时先查相应来源索引，再核对原件及其适用版本。

复核应从具体主张出发：先定位案例和原消息，区分当时建议与后来实现，再查该轮验证原件。软件测试、RTL仿真、实现时序、现场试验和事后文档整理分别表达，不能相互替代。本次格式改写没有新增硬件试验，也没有重新签发历史验收结论。
