caoc30255-eng/glitchscope/build/reports/ax7010/readme_candidate.md

# v0.12 多点毛刺工程候选比特流

按用户明确要求，在网表仿真继续期间直接生成候选bit。不是整套多点功能或硬件已验收。

源为route12_1792249299054/routed_mp12.dcp，SHA256 b42592c158c2ef9a7c07047488231fa912e318a35fc92430dd1041a45efce793。已声明约束下WNS+0.228ns、WHS+0.013ns，建立/保持失败0，16项总线偏斜最小余量+8.936ns，30184条网络全部布通，47个BRAM寄存器配置未改变。4400/4400 Slice。

功能：Direct ITEM连续1..256载荷字节，每字节一个相同bit/phase/width的毛刺。旧TYPE3A单点/禁用语义保留，新TYPE3C/ACK7C用于范围配置；CH2只标记首个毛刺，新MPG1寄存器提供点数/身份读回。7020短快照不能当作全部毛刺的波形证明。

已通过组件、复位黄金对照和49帧全板控制RTL仿真。功能网表回归、多点H1上传→START完整生命周期、PS实时多点准入/计数证据适配、真实STM32及多点实板对照仍待完成。现有PS单点执行器不会自动变为多点执行器，不应直接填入新类型并称实板通过。

这是7010纯PL bit，不含7020 HWH/Overlay或STM32程序。原8根顶层端口、引脚、电平、50/100MHz时钟约束未变；W19仍同时送到STM32和7020 CH0。

导出只写新exports/candidate12_*目录，不优化、不重新布局布线、不修改DRC严重性、不连接JTAG或下载板卡。原v0.10可用bit、v0.11失败DCP和v0.12实现DCP都保留。部署和下一组试验应使用新会话、明确已加载版本及既定复位流程，不恢复历史UNKNOWN在途记录。
