caoc30255-eng/glitchscope/report/llm_interactions_original/cases/case03_frozen_model_newlines.md

# 冻结模型哈希失败：恢复原字节，而非改凭据绕过

本文件为事后整理的案例导读，不是重写后的原始对话。原始消息编号可在独立评审记录包中定位。

## 问题

网页分析在FROZEN_CYCLE_MODEL_CHANGED处被拦截。

## 操作者的作用

操作者提供网页错误包，要求直接修复工作台。

## 模型与工具的迭代

比较原冻结模型、规范化发行文件和RTL对照凭据；发现CRLF与LF换行差异，恢复原模型LF字节，并重签包清单、增加预检回归。

## 结果

原模型哈希重新匹配既有1125案例凭据，独立分析和网页worker链路通过；没有修改模型逻辑或原RTL凭据。

## 结论边界

这是打包格式缺陷，与接线异常是两个问题。恢复后仍如实保留不可对齐窗口，不靠删除校验取得推荐。

## 原始记录定位

### m04684 · user · 2026-10-31T15:53:47.410000+00:00

评审包内路径：`raw/dialogue_20261031.md#m04684`。

> {
>   "action": "ds_analysis",
>   "created": 1637532023.4213357,
>   "error": {
>     "automatic_retry": false,
>     "error": "ValueError",
>     "message": "FROZEN_CYCLE_MODEL_CHANGED",
>     "traceback": "Traceback (most recent ca…

### m04685 · assistant · 2026-10-31T15:54:20.922000+00:00

评审包内路径：`raw/dialogue_20261031.md#m04685`。

> 这次在分析前的模型文件校验处停止，还没开始处理波形。我会核对冻结模型的预期哈希与当前文件，检查是否是源码整理时的换行转换造成差异。

### m04686 · assistant · 2026-10-31T15:55:22.145000+00:00

评审包内路径：`raw/dialogue_20261031.md#m04686`。

> 已定位：模型文件只是从LF换行转成了CRLF，代码内容没变；还原为LF后，哈希就与原RTL对照凭据完全一致。我会保留原凭据和严格校验，制作独立修复包，先验证再分析session5a，不改动板侧现有安装。

### m04687 · assistant · 2026-10-31T15:58:33.679000+00:00

评审包内路径：`raw/dialogue_20261031.md#m04687`。

> 独立修复包的软件检查已通过，也已开始只读分析session5a，模型哈希拦截没有再出现。已有一个ITEM因局部波形无法对齐而标记为`UNALIGNED`，分析器保留了这个限制；这不等于图片传输失败。

### m04688 · assistant · 2026-10-31T16:00:19.511000+00:00

评审包内路径：`raw/dialogue_20261101.md#m04688`。

> **报错原因已查明：源码打包时改变了模型文件的换行格式，导致哈希不匹配，模型逻辑没有变化。** 这与此前接线不稳定是两个独立问题。
> 
> 我已恢复模型原始字节，保留原校验凭据，并完成session5a的独立分析：
> 
> - 64个ITEM均有记录；
> - **63个局部波形可用，1个无法对齐**；
> - 因此本次**不输出整组统一d/s推荐**，也没有达到门槛的推荐区域；
> - 没有新增START或消耗额度。
> 
> [查看交互分析报告](C:/Users…

### m04689 · user · 2026-10-31T16:08:30.734000+00:00

评审包内路径：`raw/dialogue_20261101.md#m04689`。

> 把网页修了

## 工程验证关联

- `src/ps/workbench/vendor/ds/rtl_cosim_receipt.json`
- `src/ps/workbench/tests_ds_frozen_model.py`
- `docs/ui_update_20261101.md`
