caoc30255-eng/glitchscope/report/llm_interactions_original/cases/case04_dynamic_local_reference.md

# 从全64块门禁到动态N/64局部参考

本文件为事后整理的案例导读，不是重写后的原始对话。原始消息编号可在独立评审记录包中定位。

## 问题

63个窗口可用、1个未对齐时，原规则只保留全64推荐门禁，导致可用数据无法给出参考。

## 操作者的作用

操作者先要求局部参考，再明确不能写死63块，其他有效数量也应支持。

## 模型与工具的迭代

保留完整64块候选的原规则，新增共同有效窗口排序；所有14组候选只比较同一组窗口及位数，不逐块选不同d/s。

## 结果

共同有效窗口1至64块均支持局部参考；0块或完整性/模型矛盾等异常不出候选。网页、报告及JSON/CSV显示覆盖率与未参与块，候选前置且字号放大。

## 结论边界

局部参考不覆盖未评估块，不等于整图最优或推荐配置的实板验证。

## 原始记录定位

### m04699 · user · 2026-10-31T16:32:56.208000+00:00

评审包内路径：`raw/dialogue_20261101.md#m04699`。

> 局部参考候选：基于63/64块，仅供参考。加上

### m04701 · user · 2026-10-31T16:34:21.337000+00:00

评审包内路径：`raw/dialogue_20261101.md#m04701`。

> 不能只63 如果有其他数量有效 也要能够推荐

### m04702 · assistant · 2026-10-31T16:35:18.727000+00:00

评审包内路径：`raw/dialogue_20261101.md#m04702`。

> 会按实际有效数量动态推荐，1块、20块、63块都支持，不写死为63。页面会显示“基于N/64块，仅供参考”，列出未参与评估的块；所有候选d/s只在相同的有效窗口上比较，仍统一选一组参数，不为不同ITEM分别选参。

### m04706 · assistant · 2026-10-31T16:57:07.957000+00:00

评审包内路径：`raw/dialogue_20261101.md#m04706`。

> **已改成动态数量，不限定63块。**
> 
> - 有效窗口为 **1～64块**时，都可以给出局部参考候选，并显示实际覆盖数量。
> - 所有d/s按**同一组有效窗口**比较，统一选参。
> - 0块可用或证据完整性异常时，不给候选。
> - 全64块推荐与局部参考分开显示。
> 
> session5a会显示：**局部参考d4/s=-2，基于63/64块，仅供参考**，并注明未参与的第43块。
> 
> 新版已包含之前的模型哈希修复，**不用再安装上一包**：
> 
> …

### m04707 · user · 2026-11-01T00:48:10.777000+00:00

评审包内路径：`raw/dialogue_20261101.md#m04707`。

> 局部参考候选：d4 / s-2\
> 基于63/64块（98.4%），仅供参考。所有候选比较同一组有效窗口；不覆盖未评估块，不代表整图最优或实板推荐。\
> 未参与：第43块（ITEM索引42）
> 字体大一点 和**证据不足，未给出全64候选**  放在一起 放在**证据不足，未给出全64候选**  前

### m04715 · assistant · 2026-11-01T00:56:47.970000+00:00

评审包内路径：`raw/dialogue_20261101.md#m04715`。

> 可以。**这次先在新SD卡更新网页，再分析已有会话，不需要重传图片。**
> 
> 1. 如果要换卡，先停止网页服务，执行`sudo poweroff`，断电后换新卡。
> 2. 新卡启动后，若网页有活动轮次，先在“本轮管理”中结束，再按`Ctrl+C`停止网页服务。
> 3. 将电脑`C:/workspace\Desktop\GLITCHSCOPE`中的两个文件复制到板侧`test_10_14`：
> 
>    - `GLITCHSCOPE_UI_DS…

## 工程验证关联

- `src/ps/workbench/vendor/ds/tests_local_reference.py`
- `src/ps/workbench/web/ds-native.js`
- `report/verification/ui_software/local_reference_20261101.json`
