caoc30255-eng/glitchscope/report/llm_interactions_original/cases/case06_skills_review_and_revision.md

# 外部上下文评审推动六项Skill修订

本文件为事后整理的案例导读，不是重写后的原始对话。原始消息编号可在独立评审记录包中定位。

## 问题

86项原测试通过，独立评审仍发现零掩码身份校验、时钟副作用、混合访问字段、示例仿真闭环等不足。

## 操作者的作用

操作者将独立评审意见带回主线，并要求一次性完成明确缺陷及交付改进。

## 模型与工具的迭代

逐条复现和核对，补字段语义、真实适配边界、流式哈希及Python/C示例，重新运行仿真和回归；把通用能力与实测范围分开。

## 结果

形成后续修订与验证记录，进一步加入时钟审计Skill；正式目录保留195项当前回归和历史原件。

## 结论边界

独立评审会话也是模型协作，不冒充人类评委意见；跨板现场结论与有原始日志的自动检查分别标明来源。

## 原始记录定位

### m04298 · user · 2026-10-28T07:37:17.402000+00:00

评审包内路径：`raw/dialogue_20261028.md#m04298`。

> 我的评价是：**这 6 个 skill 有真实工程价值，已经超过“提示词整理”的水平，但目前更适合定位为经过离线验证的工程工具包，尚不足以称为成熟的 PYNQ 实板交付方案。**
> 
> 我查看了技能说明、实现脚本、测试、示例和部分历史证据，并重新运行了全部 **86 项离线测试，全部通过**。另外补做了几个边界检查，发现原测试没有覆盖的问题。本次没有连接 PYNQ 板卡，也没有重新执行 Vivado 仿真。[本次测试报告](C:/Users…

### m04299 · assistant · 2026-10-28T07:38:08.732000+00:00

评审包内路径：`raw/dialogue_20261028.md#m04299`。

> 这份评审总体很扎实。我会对照当前代码和PYNQ官方文档，核实指出的问题，再区分需要优先修复的缺陷与尚未覆盖的能力；这轮先分析，不改发布包。

### m04300 · assistant · 2026-10-28T07:41:01.181000+00:00

评审包内路径：`raw/dialogue_20261028.md#m04300`。

> **这份评审基本有道理，技术问题具体、定位也准确。** 我对照了当前代码和官方文档，并用假PYNQ设备独立复现了最重要的两项问题，没有连接板卡或修改发布包。
> 
> 我认可它对当前版本的定位：**经过离线验证的工程技能包，具备实用价值；尚不能等同于成熟的通用PYNQ实板方案。** 各项打分属于主观判断，不必纠结一两分。
> 
> 最需要重视的是以下几点。
> 
> **1. Bringup的两个问题确实是缺陷，应优先修复。**
> 
> 我复现得到：
> 
> ```tex…

### m04301 · user · 2026-10-28T07:44:06.913000+00:00

评审包内路径：`raw/dialogue_20261028.md#m04301`。

> 开始 一次性把所有需要修改的部分完成

### m04303 · assistant · 2026-10-28T07:54:59.257000+00:00

评审包内路径：`raw/dialogue_20261028.md#m04303`。

> 已修复零掩码和时钟副作用记录，HWH地址交叉检查也已加入。AXI工具现在要求混合寄存器显式声明字段语义，避免误清W1C状态；我还定位到Vivado启动脚本的一处环境检查，继续尝试跑通真实仿真。

### m04304 · assistant · 2026-10-28T07:59:55.474000+00:00

评审包内路径：`raw/dialogue_20261028.md#m04304`。

> 新RTL示例已在Vivado 2026.1中完成编译、展开和仿真，6个场景共384周期出现精确PASS标记。接下来会与独立软件参考逐周期比对，并注入一次背压错误，确认验证器也能抓住失败。

### m04305 · assistant · 2026-10-28T08:12:53.313000+00:00

评审包内路径：`raw/dialogue_20261028.md#m04305`。

> Python/C双实现已用同一模型文件完成470条本机查询对照；H5E1只读协议适配也通过了本机回环测试，坏CRC会记为UNKNOWN并停止。50条记录的账本测试中，完整检查模式核验了2550次证据，显式增量模式为100次，关闭时仍做全量审计。这些都是本机验证，不是板卡性能结论。

## 工程验证关联

- `skill/verification/current_summary.json`
- `skill/verification/current_unit_report.json`
- `skill/verification/cross_board_experiment.json`
