caoc30255-eng/glitchscope/report/llm_interactions_original/lifecycle_cases/l02.md

# 案例2 用短回报反例修正图片协议契约

阶段：方案设计。本文件为事后导读，不替代原始对话。

## 任务与问题

图片协议草案要求首字节前登记精确回报长度，却又允许STM32报告少于请求长度的实收数据。正常软件回归通过，仍不能排除契约本身的矛盾。

## 人工输入与决策

操作者将队友交付和反馈带入主线复核。模型核对同版文件与哈希，区分代码修复通过、协议冻结和实板验证三个不同状态。

## 反馈与修正过程

构造请求64字节、实际实收为0的合法20字节错误回报：完整CRC与身份可以成立，但按请求长度84字节登记的捕获器把它当作SHORT_FRAME。由此改为先锁定身份、窗口和最大容量，再从回报头派生长度并经完整CRC复核。

## 验证与工程结果

形成明确的软件反例、修订方向及新版本复验要求。这个案例体现模型协作不仅生成代码，也用于检查接口假设是否相容。

## 适用范围与限制

该轮是离线协议与参考模型评审，不代表AXI时钟级行为、RTL或实板已经通过；合法错误回报也不能因业务失败就被当作传输截断丢弃。

## 原话节选与原消息定位

节选去除Markdown排版；未替换原始消息。

m00319 assistant 2026-09-29T08:39:49.363000+00:00

> 两处指定修复在代码中都成立，原有回归也通过。但独立负例暴露了契约级缺口：一条 RECVD_LEN=0、完整 CRC 正确的 20 字节错误回报，被按请求长度预登记的 CH1 模型判成 SHORT_FRAME。这会丢掉本应保留的有效 DUT 错误回报。我会把结论写成验收记录，明确修复要求，不改队友文件。

相关消息：m00230、m00232、m00245、m00319、m00320

## 工程证据入口

- workspace:release_artifacts/reviews/image_stream_v0_6_3_acceptance_2026-09-29.md

- workspace:release_artifacts/design/image_stream_v0_6/contract.md
