caoc30255-eng/glitchscope/report/llm_interactions_original/lifecycle_cases/l03.md

# 案例3 固化控制链原始字节与溢出诊断

阶段：开发联调。本文件为事后导读，不替代原始对话。

## 任务与问题

早期一条试验缺少内部结果，历史现场没有完整控制UART原始字节和错误位，不能仅凭后续正常ACK确定原因。需要先让后续故障可留证。

## 人工输入与决策

操作者封存正在使用的Notebook，将诊断模块装入同一内核，依次执行正常试验、受控读取停顿与恢复试验，并回传结果。

## 反馈与修正过程

模型将临时诊断固化成版本化PYNQ模块，按阶段保存原始收包及状态。受控停顿1.5ms后，trial13023捕获0x22和溢出位0x20；即使STM32载荷正确，该次仍记INVALID。

## 验证与工程结果

9月24日归档记录确认13022正常、13023异常证据捕获、13024恢复。新增诊断能力没有改写旧网格，也没有把有DUT回报等同于完整事务有效。

## 适用范围与限制

这是故障记录与分类能力，不保证Python轮询永不溢出；也不能用新反例倒推出旧缺失记录的唯一根因。

## 原话节选与原消息定位

节选去除Markdown排版；未替换原始消息。

m00117 assistant 2026-09-24T05:38:27.814000+00:00

> 受控溢出诊断 PASS。 trial 13023 按预期记为 INVALID：M0 捕获到 0x22（十进制 34）、其中错误位 0x20，将原因标为 CONTROL_RX_OVERRUN，并写出了带 SHA-256 的诊断 JSON。STM32 收到正确 payload 不会掩盖控制链异常。

相关消息：m00094、m00107、m00115、m00116、m00117、m00118、m00124

## 工程证据入口

- workspace:release_artifacts/evidence/control_rx_m0/m0_control_rx_acceptance_2026-09-24.md

- workspace:release_artifacts/evidence/control_rx_m0/m0_control_rx_acceptance_2026-09-24.json
