caoc30255-eng/glitchscope/report/llm_interactions_original/lifecycle_cases/l04.md

# 案例4 按模块验证波特率偏差与零偏差兼容

阶段：开发联调。本文件为事后导读，不替代原始对话。

## 任务与问题

控制协议已定义有符号波特率偏差，但旧Decoder和发送器未完整接入。直接修改共用发送器可能影响控制UART，单字节观察也可能掩盖很小的频偏。

## 人工输入与决策

操作者按步骤创建RTL与测试台，在Vivado运行隔离仿真并回传PASS和失败信息。模型核对用户创建的文件与实际仿真副本哈希。

## 反馈与修正过程

从位时钟、原子配置、Decoder到连续十字节发送器逐层验证。code=0保持旧路径；跨帧累计NCO相位，增加±0.1%、±2%、±8%六点及边界拒绝。再单独检查payload旁路，避免把其他字节送入A/B。

## 验证与工程结果

隔离发送器的内容、CRC和整帧时钟数匹配参考；payload观察在±0.1%时分别表现为999和1001个时钟。验证从“文件看起来正确”推进到可观察的时序差异。

## 适用范围与限制

本案例引用的PASS限于对应隔离模块与测试输入，不能扩写为当时整板、所有故障组合或当前发行固件的完整验收。

## 原话节选与原消息定位

节选去除Markdown排版；未替换原始消息。

m00162 assistant 2026-09-24T11:15:43.275000+00:00

> 六个非零偏差点都通过了十字节内容、CRC 和整帧时序检查，M1c 的隔离发送仿真可以判 PASS。我会核对归档日志。接入内部 A/B 前还要处理一个量化问题：单字节只有 10 个 bit，±0.1% 的偏差可能在这 10 bit 内表现不出来，不能直接把结果标成已施加该偏差。

相关消息：m00132、m00136、m00151、m00158、m00160、m00162、m00163、m00178

## 工程证据入口

- workspace:release_artifacts/design/faultstim_v2_1/evidence/m1c_frame_tx_acceptance_2026-09-24.md

- workspace:release_artifacts/design/faultstim_v2_1/evidence/m1c_payload_tap_acceptance_2026-09-24.md
