caoc30255-eng/glitchscope/report/llm_interactions_original/lifecycle_cases/l05.md

# 案例7 从轮询溢出推进到原生实时接收服务

阶段：开发联调。本文件为事后导读，不替代原始对话。

## 任务与问题

长回复超过UARTLite小FIFO的及时服务能力。Python优化、后台线程及共享接收修订后仍有溢出；发送停顿也暴露了Linux调度与命令超时之间的不匹配。

## 人工输入与决策

操作者回传错误位、FIFO残留、线程权限与板端运行统计，保留失败会话，再编译独立原生库和运行新会话。

## 反馈与修正过程

模型依据新增诊断撤回“已稳定解决”的过早判断，先改交易线程共享搬运，再增加CPU亲和性、实时优先级、优先级继承锁与短暂空闲休眠。启动先读回调度设置，失败时不静默降级。

## 验证与工程结果

10月16日回传1000次远端只读交易全部通过，最大交易内接收服务间隔约0.165ms；随后CONFIG和首个256字节ITEM完成真实回传、核验与严格退役。

## 适用范围与限制

普通内存调度验证、只读交易压力与真实ITEM是三个层级；有限压力结果不构成普通Linux永不丢字节的保证。旧溢出会话没有自动恢复。

## 原话节选与原消息定位

节选去除Markdown排版；未替换原始消息。

m01778 assistant 2026-10-15T14:56:59.998000+00:00

> 残留原件已保存：后台留住首字节 A5，硬件 FIFO 留住后续 16 字节，与接收溢出相符。当前 Notebook 进程有调度权限，可以尝试改进接收服务。

m01779 assistant 2026-10-15T14:58:44.016000+00:00

> v5 的启动会先核验调度策略、优先级、CPU 亲和性和锁协议；任一设置失败，就停止启动，不会静默退回普通轮询后继续试验。这能改善调度条件，但不能保证普通 Linux 上永不溢出，仍需压力测试。当前已溢出的会话不会恢复。

相关消息：m01346、m01444、m01448、m01519、m01776、m01778、m01779、m01799、m01801、m01803、m01805

## 工程证据入口

- workspace:PS_UART_RT_v5_2026-10-15/README_先读.md

- formal:src/ps/native/uartlite_service_v5.c
