caoc30255-eng/glitchscope/report/llm_interactions_original/lifecycle_cases/l06.md

# 案例8 用实际受损图片验证CRC约束修复

阶段：功能验证。本文件为事后导读，不替代原始对话。

## 任务与问题

图片功能必须先证明展示的是实际接收的坏图，再证明修复来自接收数据计算。不能把发送原图覆盖到结果上，也不能把CRC检错本身说成纠错算法。

## 人工输入与决策

操作者执行整图会话并交回原件。模型先核验受损图来源，再独立重建修复结果，分列B接收图与STM32回报。

## 反馈与修正过程

保留CRC失败的数据，使用块CRC约束搜索及多路接收择优，按整图SHA验证精确恢复。早期方案中的重传设想没有被偷换为已经实现的功能；本次恢复依据保存的接收原件重算。

## 验证与工程结果

10月19日session27核验记录含65次START、DONE及严格退役，实际毛刺计数8394。单B修复剩483个错误像素，多路融合结果为0且SHA匹配；这是一组有实收来源的功能证据。

## 适用范围与限制

CRC匹配候选不等于唯一原文，整图SHA一致才支撑该次精确恢复。单张图片通过不代表任意损伤都能修复，也不说明STM32硬件接收本身被调优。

## 原话节选与原消息定位

节选去除Markdown排版；未替换原始消息。

m02635 assistant 2026-10-19T15:03:56.788000+00:00

> session27 原件核验通过：65 次 START、DONE、严格退役和下一条许可都对应，64 份多点配置 ACK 及实际计数共 8394 点；修复结果也从接收原件重新算出，单 B 剩 483 个错误像素，多路融合为 0。下一步主线应转向固定条件的真实容错网格扫描，再验证 AI 是否能减少同等精度下的试次。

相关消息：m02378、m02379、m02515、m02635、m02636

## 工程证据入口

- workspace:release_artifacts/reviews/random_image_session_00000024_2026-10-18/核验结论.md

- formal:report/verification/workbench_repair/repair_delivery_review.json

- formal:report/verification/workbench_repair/actual_raw_contract.json
