caoc30255-eng/glitchscope/report/llm_interactions_original/lifecycle_cases/l07.md

# 案例9 从模拟网格走到真实容错热力图

阶段：功能验证。本文件为事后导读，不替代原始对话。

## 任务与问题

界面能显示14格或模型流程完成，不代表硬件边界已经测出。还需要区分B整帧正确、STM载荷正确与STM业务成功。

## 人工输入与决策

操作者按受控计划执行新会话并提供完整证据。模型先在软件层验证预算、异常停止与原件篡改拒绝，再检查板端记录。

## 反馈与修正过程

计划采用CONFIG与无扰动参照各1条、14格各3次，共44条。逐条核对参数读回、42次毛刺快照、原始接收结果和退役证明，再独立重算三类统计。

## 验证与工程结果

10月20日session29的44条完成严格退役，无UNKNOWN；三类统计与网页一致。B在相位15、宽度10出现2/3正确，STM某些格点载荷正确却业务失败，证实不能合并判据。

## 适用范围与限制

每格3次属于粗扫描，混合结果需要保留；少量重复不是确定边界或普遍概率保证。44条是这份配置的计算结果，不是所有扫描的固定条数。

## 原话节选与原消息定位

节选去除Markdown排版；未替换原始消息。

m02705 assistant 2026-10-20T06:38:03.146000+00:00

> 原始证据核验通过：44条均完成严格退役，42次单点毛刺快照有效。实测中出现了混合结果：B在“相位15、宽度10”为2/3正确；STM在部分格点载荷正确，却报告业务失败，说明这两个判据确实需要分别展示。

相关消息：m02561、m02640、m02642、m02643、m02701、m02703、m02705、m02706

## 工程证据入口

- workspace:release_artifacts/reviews/session29_real_scan_2026-10-20/核验结论与下一步.md

- workspace:STM_B_Real_Heatmaps_Baseline_2026-10-21/实测基准报告.md

- formal:report/verification/scan_backend/owner_review.json
