caoc30255-eng/glitchscope/report/llm_interactions_original/lifecycle_cases/l08.md

# 案例10 把参数推荐限定为同波形的可验证比较

阶段：功能验证。本文件为事后导读，不替代原始对话。

## 任务与问题

模型先后提出利用上一块反馈或已知毛刺计划选参，但独立随机扰动不能由上一块预测，读取注入计划也不符合未知干扰接收的目标。局部快照又不等于完整帧波形。

## 人工输入与决策

操作者要求分析本次实际波形，明确采用软件推演，并决定第三功能不使用AI。后续统一参数用于64块，不允许每块各取一组d/s。

## 反馈与修正过程

转向与B接收器一致的逐周期软件模型，保留初相歧义，比较同一组有效窗口中的14组d/s。31段早期波形中21段一致、10段不确定，没有用目标答案反选初相；再由操作者运行RTL对照。

## 验证与工程结果

10月22日回传1125用例、11389950周期对照通过。后续两张图片四组260条独立配对验收中，统一d4/s-2相较基线减少位错约30.3%和35.4%，保留具体条件与原件关联。

## 适用范围与限制

模型与RTL一致不能补回采集时缺失的内部初相；软件候选、局部范围和重新实测的参数效果分层报告，不宣称全条件最优，也不改写原接收数据。

## 原话节选与原消息定位

节选去除Markdown排版；未替换原始消息。

m03163 user 2026-10-21T14:42:17.577000+00:00

> 那就不采用ai 测量不同表决间距、位置的误码表现，给出经过验证的推荐区域。功能能不能补充到第三项

相关消息：m03082、m03086、m03158、m03162、m03163、m03165、m03171、m03201、m03202、m03893

## 工程证据入口

- formal:src/ps/workbench/vendor/ds/rtl_cosim_receipt.json

- formal:report/verification/ds_analysis/owner_acceptance.json
