caoc30255-eng/glitchscope/report/llm_interactions_original/lifecycle_cases/l09.md

# 案例11 验收边缘AI的运行闭环与选点范围

阶段：功能验证。本文件为事后导读，不替代原始对话。

## 任务与问题

模型能推理、跨平台输出一致、闭环能选点，以及是否比规则更省试次，是不同的验证问题。不能把开源组件接入或软件测试通过直接等同于扫描提效。

## 人工输入与决策

操作者要求覆盖自选配置，执行ARM软件检查与三组实板对照，交回失败和修复后的报告。模型根据这些结果限定已学习范围和回退规则。

## 反馈与修正过程

对ARM浮点末位误差，只给score与entropy指定1e-12绝对容差，类别、动作和权限严格比较，模型权重不改；45条黄金查询和450条C对照通过。随后按14条规则、14条AI、44条参照执行有界对照。

## 验证与工程结果

三组共72条流程完成；规则和AI各测4格，均触及新参照6个边界格点中的2格，主要覆盖指标持平。项目保留二者作为减少选点的并列策略，不要求AI优于规则才允许使用。

## 适用范围与限制

本轮确认推理、选点、反馈与证据链可运行，不支持AI普遍更快、更准或所有自选条件均经实板验证。完整14格图来自参照组，不能将稀疏选点展示成全网格实测。

## 原话节选与原消息定位

节选去除Markdown排版；未替换原始消息。

m03996 user 2026-10-26T13:04:13.824000+00:00

> 边缘ai是否通过

m03994 assistant 2026-10-26T12:41:11.669000+00:00

> 独立复核已通过：C组44条全部有效，与板端统计一致。三组比较也已确认：AI和规则的主要指标持平，本轮可以确认AI选点与反馈闭环正常，但还不能验收为“AI提效”。

相关消息：m03904、m03908、m03913、m03962、m03964、m03966、m03990、m03994、m03995、m03996、m03997

## 工程证据入口

- formal:report/verification/edgeai_arm/owner_review.json

- formal:report/verification/edgeai/owner_final_comparison.json

- formal:docs/selection_methods.md
