caoc30255-eng/glitchscope/report/llm_interactions_original/lifecycle_cases/l10.md

# 案例13 把外部评审转化为Skill缺陷修订

阶段：交付复现。本文件为事后导读，不替代原始对话。

## 任务与问题

86项原测试通过后，另一次上下文评审仍发现零掩码身份校验、时钟副作用记录、混合寄存器字段语义和新仿真示例闭环不足。

## 人工输入与决策

操作者将评审意见带回主线并要求集中修订。模型逐项核对并复现，不把外部评分当作自动证明，也不直接把评审文字当作实现要求。

## 反馈与修正过程

补零掩码拒绝、HWH地址核对、字段级访问语义、流式哈希与Python/C示例，运行新RTL示例及负向验证，并区分真实适配和合成测试范围。

## 验证与工程结果

修订与验证资料进入正式Skill目录；随后加入时钟审计能力，当前归档保留195项回归和各阶段原件。评审推动了实现与自动检查，而不仅是说明文字扩充。

## 适用范围与限制

独立评审会话同样属于模型协作，不冒充人类评委意见。回归测试、现场跨板结论和具备原始日志的实测分别记录来源。

## 原话节选与原消息定位

节选去除Markdown排版；未替换原始消息。

m04301 user 2026-10-28T07:44:06.913000+00:00

> 开始 一次性把所有需要修改的部分完成

m04303 assistant 2026-10-28T07:54:59.257000+00:00

> 已修复零掩码和时钟副作用记录，HWH地址交叉检查也已加入。AXI工具现在要求混合寄存器显式声明字段语义，避免误清W1C状态；我还定位到Vivado启动脚本的一处环境检查，继续尝试跑通真实仿真。

相关消息：m04298、m04299、m04300、m04301、m04303、m04304、m04305

## 工程证据入口

- formal:skill/verification/current_summary.json

- formal:skill/verification/current_unit_report.json

- formal:skill/verification/cross_board_experiment.json
