caoc30255-eng/glitchscope/report/llm_interactions_original/lifecycle_cases/l11.md

# 案例14 核对名义频率与板载参考时钟

阶段：交付复现。本文件为事后导读，不替代原始对话。

## 任务与问题

PYNQ显示FCLK0为150MHz，但150MHz时序签核没有通过。若不核对参考频率，可能把软件计算读回误当成实际配置频率。

## 人工输入与决策

操作者提出实际可能仍为100MHz，并回传7020只读寄存器、设备树及AX7010的PYNQ2.4环境结果。

## 反馈与修正过程

模型转向检查PYNQ的50MHz参考假设与板侧约33.333333MHz声明，结合PLL倍频30和两级分频5、2推导；同时修复采集器对旧版类方法接口的兼容性。

## 验证与工程结果

配置推导支持当前FCLK0约100MHz；正式文档区分PYNQ名义150读回与参考加寄存器推导。没有仅为读数名称修改setter或制造150MHz签核通过结论。

## 适用范围与限制

这是参考与配置一致性审计。当前发行说明依据实际交付范围和100MHz时序结果，不将软件读回当作完整硬件身份或频率证明。

## 原话节选与原消息定位

节选去除Markdown排版；未替换原始消息。

m04343 user 2026-10-29T02:15:32.684000+00:00

> 你先联网搜索一下pynq的问题 我感觉是pynq设置虽然是150mhz 但实际上板子上的还是100

m04422 assistant 2026-10-29T09:38:32.974000+00:00

> 原因已找到：旧脚本按PYNQ 2.7的时钟接口识别，PYNQ 2.4采用不同结构。官方2.4源码

相关消息：m04343、m04362、m04363、m04400、m04422、m04423

## 工程证据入口

- formal:docs/clock_reference.md

- formal:report/verification/clock_reference/board_readonly_excerpt.json

- formal:skill/pynq-clock-reference-audit/SKILL.md
