caoc30255-eng/glitchscope/report/llm_interactions_original/lifecycle_cases/l12.md

# 案例15 修复冻结文件并保留部分证据的用途

阶段：交付复现。本文件为事后导读，不替代原始对话。

## 任务与问题

工作台分析在FROZEN_CYCLE_MODEL_CHANGED处被拦截；恢复原模型后，另有1块局部波形无法对齐，原全64规则不能给出完整候选。两类问题需要分别处理。

## 人工输入与决策

操作者提供报错包，要求修复网页，并进一步要求局部参考支持任意实际有效数量，不能写死63块；同时指定覆盖率、未参与块与大字号提示。

## 反馈与修正过程

模型对照原冻结凭据，发现CRLF/LF换行差异，恢复原字节而不改凭据绕过。随后新增共同有效窗口比较：14组候选使用同一组窗口，局部参考与全64候选分开。

## 验证与工程结果

模型哈希重新匹配既有RTL凭据，网页与worker链路恢复。有效窗口1至64块可给局部参考；0块或完整性、模型矛盾时不出候选，界面明确列出N/64覆盖和未参与块。

## 适用范围与限制

局部参考不覆盖未评估块，不代表整图最优或推荐参数已实板验证。修复打包字节与解释数据覆盖范围，不等于放宽采集真实性校验。

## 原话节选与原消息定位

节选去除Markdown排版；未替换原始消息。

m04701 user 2026-10-31T16:34:21.337000+00:00

> 不能只63 如果有其他数量有效 也要能够推荐

相关消息：m04684、m04686、m04688、m04689、m04699、m04701、m04702、m04706、m04707

## 工程证据入口

- formal:src/ps/workbench/tests_ds_frozen_model.py

- formal:src/ps/workbench/vendor/ds/tests_local_reference.py

- formal:docs/ui_update_20261101.md
