caoc30255-eng/glitchscope/report/llm_interactions_original/lifecycle_cases/l13.md

# 案例16 备用SD冷启动与真实记录复现

阶段：交付复现。本文件为事后导读，不替代原始对话。

## 任务与问题

已有安装能够运行不能代替干净环境首次部署。备用卡复现还出现图片波形异常，必须区分源码迁移、运行环境、采集读回和现场连接等可能原因。

## 人工输入与决策

操作者从备用7020镜像启动，执行软件复现、编译原生库及0历史初始化，提供新旧卡对照、快照和最终成功会话；现场重新固定接线。

## 反馈与修正过程

模型保留失败会话与UNKNOWN，核对多次读回和旧卡复现，撤回仅凭新卡或相位解释问题的判断。固线后重新核验未放宽的波形校验，再把通过的分支与部署说明合入发行包。

## 验证与工程结果

fresh_runs/session7完整原件3067文件归档核验，65条严格退役、64份毛刺波形检查通过；多路CRC修复整图SHA一致，64/64局部窗口在ARM完成分析，统一软件候选d4/s-2。初始会话、试验记录与额度均为0。

## 适用范围与限制

备用卡现场启动与初始化来自操作者回传，session7原件单独核验；不把旧卡成功冒充fresh_runs。固线后的成功支持现场判断，但不能扩写成独立电气因果测量；该次软件候选也不等于所有条件最优。

## 原话节选与原消息定位

节选去除Markdown排版；未替换原始消息。

m04567 user 2026-10-31T11:03:04.129000+00:00

> 我准备好备用SD冷启动全流程复现了 7020已插入空白7020镜像

m04720 user 2026-11-01T01:52:25.549000+00:00

> 新卡ds以及图片都成功

相关消息：m04567、m04568、m04574、m04576、m04577、m04626、m04673、m04676、m04720

## 工程证据入口

- formal:docs/first_installation.md

- formal:docs/fresh_sd_acceptance_20261101.md

- formal:report/verification/ui_software/fresh_sd_session7_20261101.json
