caoc30255-eng/glitchscope/report/llm_interactions_original/lifecycle_cases/p01.md

# 案例5 迁移已有接收器并验证7020数字顶层

阶段：开发联调。本文件为事后导读，不替代原始对话。

## 任务与问题

队友接手时需要区分重新设计A/B算法与迁移已有实现。旧7010通过的配置不能直接视为7020上的最优参数，隔离模块通过也不等于完整PS系统可运行。

## 人工输入与决策

队友操作者明确询问是重做还是验证后迁移，并要求先完成数字集成。该需求通过独立队友会话记录，而非主线模型代述。

## 反馈与修正过程

队友会话中的模型以7010固定A和可调三点表决B为基线，适配共享CH0同步前端、配置与读回，连接帧关联和Gateway数字发送原型，并单独说明完整Block Design和实体链路边界。

## 验证与工程结果

队友R021记述Vivado2018.3联合仿真4组场景、309项检查及独立综合通过，覆盖正常发送、A译错后如实转发、选择B和身份受扰拒绝。此次纳入的是可见协作记录，未重新执行该历史仿真。

## 适用范围与限制

这是早期单字节数字顶层的迁移过程，不能据此把Gateway实体链路、图片FIFO或最终整机一并标为当时已验收。原F盘源码与完整构建日志不在本次记录包中。

## 原话节选与原消息定位

节选去除Markdown排版；未替换原始消息。

peer_R018_M01 user 2026-09-27T09:07:38+00:00

> 这个项目之前在7010配置的接收器做过ab接收器了 我们是要重新做还是验证之后迁移

相关消息：peer_R018_M01、peer_R018_M02、peer_R021_M01、peer_R021_M04

## 工程证据入口

- peer:附录/对话可见消息与操作索引.json

- peer:完整协作记录.md
