caoc30255-eng/glitchscope/report/llm_interactions_original/lifecycle_cases/p03.md

# 案例12 从UI审批原型到可演示的交互要求

阶段：交付复现。本文件为事后导读，不替代原始对话。

## 任务与问题

功能后端与演示界面由不同工作线推进，不能把独立UI演示当作已经连通硬件的工作台。初版图片滑块固定两侧来源，也不满足自由比较要求。

## 人工输入与决策

队友操作者传达完整三功能设计要求，转交左右自由选图反馈，又要求三条波形作为主要演示。主线随后提出导航字号、AI并入扫描和d/s页样式统一的修改。

## 反馈与修正过程

队友原型补左右独立选图、交换、滑块位置、差异重算与软件重建曲线，按新版本保留；主线接手后继续做服务接口与原生d/s视图的集成检查。

## 验证与工程结果

R175至R178可追溯7页审批稿、自由选图修订、三波形与展示版迭代；主线m04019记录UI代码与接口检查。两条记录共同说明设计输入、反馈、修订到集成的交接，而非一个模型独自完成所有环节。

## 适用范围与限制

队友原型数据标为UI演示、未接硬件；主线软件集成也不替代后续实板验收。绿色曲线为软件重建，不称为再次实际发送的电气波形。

## 原话节选与原消息定位

节选去除Markdown排版；未替换原始消息。

peer_R176_M01 user 2026-10-23T11:59:04+00:00

> 负责人回复，滑块展示应该能自由选左右图片，是不是没做？

相关消息：peer_R175_M01、peer_R175_M09、peer_R176_M01、peer_R176_M05、peer_R177_M01、peer_R177_M05、peer_R178_M12、m04013、m04019

## 工程证据入口

- peer:附录/对话可见消息与操作索引.json

- formal:src/ps/workbench/verification_record.json
