caoc30255-eng/glitchscope/src/ps/workbench/samples/ds64/report_notes.md

# 第三功能分析报告

会话：session_00000049

状态：COMPLETE

统一d/s软件候选：[{"d": 4, "s": -2}]

达到声明门槛的候选区域：[]

以下是局部窗口软件模型的保守范围，不是候选配置的整图实测误码。

|d|s|已评分窗口|局部位数|误码下界|误码上界|全64排名资格|
|---:|---:|---:|---:|---:|---:|---|
|1|-2|64/64|1024|34|41|True|
|1|-1|64/64|1024|37|39|True|
|1|0|64/64|1024|39|49|True|
|1|1|64/64|1024|42|53|True|
|1|2|64/64|1024|43|49|True|
|2|-2|64/64|1024|32|36|True|
|2|-1|64/64|1024|35|38|True|
|2|0|64/64|1024|38|45|True|
|2|1|64/64|1024|37|46|True|
|3|-2|64/64|1024|27|30|True|
|3|-1|64/64|1024|28|31|True|
|3|0|64/64|1024|30|38|True|
|4|-2|64/64|1024|19|24|True|
|4|-1|64/64|1024|22|25|True|

输入门控：OFFLINE_FILE_COPY_NO_POSIX_GATE

参考前缀假设：True

硬件验证推荐区域为空；不替换原接收数据，不发送新START。

报告包含全局候选与门槛区域、64块状态、三条轨迹、相位与表决点浏览，以及JSON/CSV/SVG导出。

完整原始接收证据另存于原会话；本目录是分析产物。
