caoc30255-eng/glitchscope/docs/github_readiness.md

# GitHub发布前完整性与匿名审查

审查日期：2026-11-02。依据用户提供AMD指南3.3自主选题及其SHA校验，工程内容已形成可公开的独立匿名副本。本文件不记录用户指定的身份关键词。

## 指南对应与完整性

|检查项|实际材料|结论|
|---|---|---|
|工程源码与上板文件|src/pl、src/ps、src/stm32、board/firmware|齐备；运行逻辑、位流、HEX、原生库及模型按原来源保留|
|仿真及功能验证|sim、report/verification、软件自测|分层记录齐备；不混合软件测试与实板试次|
|性能与资源对比|设计报告第5章、build/reports、fresh_reproduction_results|有配对基线、记录消耗和覆盖、资源及时序；不声称150MHz通过|
|可复现脚本|build与board入口、部署文档|已提供；本次未重新执行整轮EDA构建或实板验证|
|设计报告|report/design_report/design_report.pdf|2026-11-04修订PDF，40页；补充AI建议取舍与人工复盘，见当日核验凭据|
|大模型协作|report/llm_interactions_original|26页PDF、案例及来源索引；原始私有材料不上传|
|技能包|skill|七项技能及已归档195项回归、适用范围和失效条件|
|目录与命名|src、sim、build、board、data、skill、report及README映射|名称规范化；RTE目录已改为小写；gitignore未遗漏必需文件|
|许可与公开素材|LICENSE、third_party_notices.md、公开投影说明|自有代码MIT，第三方署名保留；独立演示图像与完整接收包保持不公开；报告内展示图按2026-11-03用户指定版本发布|
|目录外独立材料|队伍资料、官方英文海报、最终演示视频|按用户要求不纳入工程目录，不作为源码缺项|

## 身份检查范围

已检查用户提供的注册编号、队名、成员姓名、所属学校及学校英文／域名变体。扫描覆盖文件名、源码与注释、JSON、HTML、Notebook、日志、PDF正文及隐藏属性、二进制可读字符串；另检查了图片与报告版面。没有发现上述身份字段。本地个人账户路径已经匿名化。

保留厂商版权、第三方许可证、文献作者及文献机构，它们不属于参赛身份。公开扫描摘要不附带非必要的逐包哈希字段；原始校验值及其含义保留于私有原件，未改动实验统计。私有关键词表和详细匹配上下文不随包发布。

## 实际完成的检查

- 70项主工作台软件测试通过，涵盖账簿、停止、权限、HTTP、首次安装与冻结模型。
- 公开扫描摘要裁剪非必要逐包哈希后，另有13项HTTP及历史数据集成检查通过；统计结果保持不变。
- 浏览器切换64个ITEM、14组d/s、14个保留初相并下载CSV，页面错误为0。
- 64份CAP和候选评分保持原值；262144个参考采样点与原显示逻辑一致。只公开窗口所需320个字节，不含完整图像帧。
- 485份执行逻辑、固件及模型相关文件与私有原件逐字节一致；模型黄金凭据没有重签。
- 当前文件由release_manifest.json校验；公开派生关系由public_projection_manifest.json记录。原始评审证据及旧发布包未改写。

## 发布时的边界

只上传本匿名目录内容，不上传原工程父目录、私有证据包、旧ZIP、私有审查工作区或旧Git历史。发布者已于2026-11-03授权使用正常GitHub账号、提交作者和邮箱；工程内容继续不包含参赛身份字段。推送状态以仓库实际记录为准。若后续加入新截图、日志或文档，应对新内容重新执行身份检查。

现有已验收硬件与分阶段复现记录支持相应功能和工件；本次公开整理不追加“全新统一入口整轮复现通过”或新固件实板验收结论。

2026-11-03补充：仅更新设计报告及关联说明、来源与校验清单，按本次PDF重新检查身份字段和页面。历史硬件、软件与素材整理结论仍对应原检查时点；未重跑实板试验。
