caoc30255-eng/glitchscope/docs/llm_collaboration.md

# 大模型协作记录

当前阅读入口为[大模型协作记录Markdown](../report/llm_interactions_original/llm_collaboration_with_v1.md)，保留22个案例，覆盖V1基线以及方案设计、开发联调、功能验证、交付复现。新增AI协助要点、采纳与撤回方案、依据实际人工决策浓缩的复盘心得。原26页PDF作为历史整理版本保留，不是本次更新后的全文。

主线可恢复4750条可见消息；协作方另列2条对话、179轮、739条可见消息，两来源不相加作为去重总数。V1另有7份有界缓存、35条片段和9份工程资料，缺失日期、模型信息与对话不补写。

`v1_source_map.json`与`lifecycle_source_map.json`保留来源定位。完整原始对话和附件由独立评审资料归档，不默认公开到Git。Markdown为事后整理，人工心得不冒充逐字原话；历史凭据不表示重新运行试验。
