caoc30255-eng/glitchscope/docs/clock_reference.md

# 7020时钟口径与PYNQ参考频率

## 当前已验收环境

领航者V2（7020）的PS参考晶振为33.333333MHz，原理图和设备树声明一致。2026-10-29返回的板侧只读检查显示：PYNQ 2.7.0的`_ClocksZynq`实例仍按50MHz参考频率计算，`Clocks.fclk0_mhz`读回150MHz。因此，PYNQ读回值不是本项目的物理测频结果。

|项目|值|
|---|---|
|PYNQ计算采用的参考频率|50MHz|
|板卡参考晶振／设备树声明|33.333333MHz／33333333Hz|
|FCLK0源|IO PLL|
|PLL反馈倍频|30|
|FCLK0分频|5×2|
|PYNQ显示值|150MHz|
|按板卡参考晶振与寄存器推算|约100MHz|

`33.333333 × 30 ÷ 5 ÷ 2 ≈ 100MHz`。两次寄存器读取一致，PLL锁定且未旁路。CPU读回1150MHz也使用相同参考频率换算，不能直接当作实际CPU频率。

完整字段摘录及来源见`../report/verification/clock_reference/board_readonly_excerpt.json`。这属于参考晶振、设备树和寄存器计算相互核对，尚未用示波器或独立频率计测量。

## 为什么仍保留代码中的150

依照本次要求，保留当前已验收的PYNQ环境和`Clocks.fclk0_mhz = 150`配置，不修改PYNQ安装文件、参考常量或分频寄存器。这个150仅适用于上述环境，是PYNQ API使用的名义值，不能写成“7020实际以150MHz运行”。

不要孤立地把150改为100：在旧参考频率下它可能把真实频率降至约66.67MHz。也不要仅修正PYNQ参考频率却继续请求150：那可能真的把PL设到150MHz。迁移到其他镜像、参考频率已修正的PYNQ或其他板卡时，须先运行`board/clock_readonly_probe.py`，核对参考频率、PLL与分频，再决定配置值；不得直接照搬150。

## 时序报告解释

已验收7020路由检查点在100MHz约束下：WNS +0.048ns、WHS +0.057ns，建立／保持／脉宽违例均为0，路由完整。它与当前配置推算出的约100MHz工作条件相符。

另行按6.666ns（150MHz的保守1ps取整）复查原路由：WNS -3.286ns、28303个建立违例端点。新150MHz目标纯布局优化候选仍未通过，WNS -3.822ns。它们是更高频率条件下的独立检查，不证明当前装置实际超频，也不能包装成150MHz签核通过。本发行版不替换已验收位流，不采用该候选。

## 报告和界面用语

统一表述为：“PYNQ读回150MHz；按33.333333MHz板卡参考频率与当前分频寄存器推算约100MHz；未做物理测频”。若界面、旧Notebook或历史记录显示150，应按此说明解释，不改写历史原件。

这次只补充文档与代码注释。未更改网页执行逻辑，未新增时钟写入、Overlay加载、试验START或训练。注释导致源码校验值变化，未来重新部署本发行版时仍须正常完成该版本的目标板软件检查，旧凭据不得移植。

## 官方机制依据

- PYNQ 2.7.0官方源码：https://pynq.readthedocs.io/en/v2.7.0/_modules/pynq/ps.html ：Zynq参考频率默认50MHz；频率读取由PLL和分频寄存器计算。
- AMD UG585：https://docs.amd.com/r/en-US/ug585-zynq-7000-SoC-TRM/Clocks-and-PLLs ：PLL以PS_CLK为输入参考。

板上安装代码的参考值与计算函数已由只读脚本返回，结论不只依赖网上默认版本。
