caoc30255-eng/glitchscope/docs/delivery_version_audit_20261101.md

# 交付版本核对 · 2026-11-01

|范围|核对结果|本次处理|
|---|---|---|
|外壳|旧v5落后于实际打印v16|替换为v16保留亚克力上下叠放方案；附10月31日装配指南|
|PL/PS/STM32及既有源文件|原3442条源文件哈希匹配；3个构建脚本与既有修复凭据一致，来源清单旧交付哈希已同步|保持已验证源码，不追入未验收候选|
|正式工作台|manifest与成功fresh SD session7绑定一致；内部逐文件清单一致|运行代码不变|
|固件/RT库/模型|既有来源绑定一致|不替换为布局候选、重训产物或快速回放实现|
|七项技能|现行v1.2.1，既有195项验证凭据与两板时钟采集保留|未发现需要追入的新版实现|
|新SD验证资料|session7摘要、来源、完整私有原件索引已在包中|保留图片/分析范围和单独软件原报告待取回的边界|
|大模型记录|26页、22案例最新版及来源索引已在包中|不恢复旧稿|
|当前说明|README及复现页存在早期待验表述|按现有证据更新；历史时间线不回写|

本核对基于本地可见来源、冻结清单和已归档验收记录；不是重新执行硬件验收，也不是宣称已覆盖所有可能存在的外部分支。源码来源文件日期更晚不自动等于可替换版本。

## 仍留空或待提供

设计报告、团队资料、官方英文海报、最终完整演示视频、素材公开授权仍按既有清单留空。150MHz签核不作为当前约100MHz推算配置的性能主张，原失败记录不变。30秒片头和标题段不等同完整功能演示。

14份STL从原v16打印包逐字节复制，只将文件名改为英文并标注数量。实物装配照片和检查反馈见hardware/measured_enclosure_fit。早期外壳文件已在提交目录外备份，不包含在当前源码包。

## 2026-11-02 设计报告合入

上述留空状态描述原检查时点。现已将经复核的39页PDF加入`report/design_report/design_report.pdf`；团队资料、英文海报、最终视频等其他材料的当前状态仍以`submission_checklist.md`为准。软件、固件和历史验收结果未改变。

## 2026-11-02 工程包范围调整

按用户要求，队伍信息、官方单页英文PPT／海报及最终完整演示视频在工程目录外单独准备；不再保留相应空目录，也不作为本工程包缺项。此前留空说明为历史时点记录。
