caoc30255-eng/glitchscope/docs/fresh_sd_acceptance_20261101.md

# 备用SD：新安装图片与d/s功能验收 · 2026-11-01

## 已完成的范围

操作者从匹配7020镜像的备用SD启动，返回PYNQ2.7.0、Python3.8.2、armv7l环境信息；目标软件/原生库检查通过，初始化新安装时会话、试验记录和批准额度均为0，网页空状态确认完成。这些启动/初始化事实来自本轮操作输出，不由文件夹名称单独证明。

本次成功原件属于同一新安装的 `fresh_runs/session_00000007`，不是旧卡 `board_runs/session_0000005a` 的替代或改名。安装ID为 `6d60a9b1befa4f27906c8f7adb9bd0af`。原始会话3067文件、65条有效严格退役结果、64份MARK快照已归档；782份提交清单与d/s报告引用的1432文件核对通过。

## 图片结果

65条全部完成，UNKNOWN为0，接收器与锁已释放。多路CRC修复错误像素0、整图SHA-256匹配；仅B修复仍有425个错误像素，不能混称所有算法均无损。四种修复方式使用原始接收证据重放后，输出字节均与板侧导出一致。重新固定接线后完整执行成功的现场结论保留，旧故障及UNKNOWN不回写。

## 统一d/s分析

板侧ARM完成64/64个局部窗口分析；14组参数的评分和排序已独立复算，统一软件候选为d4/s=-2。比较范围是1024个局部评分位，保守位错范围15至27、停止位错误范围0至0。没有配置达到本轮零错门槛，没有为该新图片条件新增推荐参数的实板复核；不声称整图硬件最优。参考前缀及接收初相不确定性继续保留。

## 版本与证据边界

成功任务的版本绑定与 `GLITCHSCOPE_UI_DS_Display_20261101` 中已发布fresh分支一致，冻结模型及分析源码哈希匹配。独立的软件检查原报告文件尚未单独取回，已保留原任务授权中的报告哈希和版本绑定，不据此编造一份新报告。

此前fresh_runs顺序扫描44条、配置AI策略14条的导出检查结论保留。本次session7核验不替代对那两次扫描完整原始生命周期和AI/规则兜底来源的独立复核，也不构成所有自选参数、图片和随机种子的普遍保证。

完整原件位于交付根目录的 `submission_evidence/fresh_sd_session7_20261101.zip`，含图片源数据，仅用于评审/归档，不默认放入公开Git仓库。公开源码内只保留本说明和不含图片像素的摘要。原始输出中的早期pending标记保留，通过本次追加核验记录说明后续结论。

2026-11-01后续已将上述成功会话版本哈希一致的fresh分支合入正式主线，新增从零部署指南和入口；原部署兼容逻辑仍保留。设计报告和其他约定缺项目录继续留空。

## 2026-11-02 设计报告合入

上述留空状态描述原检查时点。现已将经复核的39页PDF加入`report/design_report/design_report.pdf`；团队资料、英文海报、最终视频等其他材料的当前状态仍以`submission_checklist.md`为准。软件、固件和历史验收结果未改变。

## 2026-11-02 工程包范围调整

按用户要求，队伍信息、官方单页英文PPT／海报及最终完整演示视频在工程目录外单独准备；不再保留相应空目录，也不作为本工程包缺项。此前留空说明为历史时点记录。
