caoc30255-eng/glitchscope/docs/package_review_20261102.md

# 交付内容检查 · 2026-11-02

当前说明已统一为面向项目使用者的结构：架构、三项功能、部署、构建、验证、开源与提交清单。删除无关旧方案引用，合并重复状态，更新新SD主线和装配状态，并将个人电脑路径示例替换为通用示例。

## 已检查

- 当前发行说明与README的版本、功能与证据范围一致。
- 运行源码、固件、模型权重、STL几何未改变。
- 未发现环境密钥文件、SSH私钥、临时中断文件或编辑器备份文件。
- 文本中未发现常见私钥签名和AWS访问密钥签名；这是有限格式检查，不替代完整安全审计。
- 105份日志属于验证记录，予以保留。测试中的假设备、临时目录机制及机械源文件中的实际板卡术语是实现所需内容。
- 原始协作记录、实验报告及失败/UNKNOWN记录按来源保留，不修改历史内容。
- 设计报告、团队资料、海报与最终演示视频等材料状态见submission_checklist.md。

原始图片、第三方文件与公开素材的授权遵循既有说明；独立评审资料和公开源码分开分发。

## 设计报告复核与合入

39页PDF通过内容逻辑、原件数据口径和逐页版面检查，已加入设计报告目录。隐藏属性中的旧组别标注已清理，39页可见内容逐像素保持不变。设计报告目录已从必须留空清单移除，运行代码、固件、模型和历史证据不变。复核凭据见`report/verification/design_report/review_20261102.json`。

## 工程包范围

队伍信息、官方单页英文PPT／海报及最终完整演示视频按用户要求独立准备，不纳入本目录或工程包。三项空目录及必须留空约束已移除；设计报告继续保留。
