caoc30255-eng/glitchscope/docs/ui_update_20261101.md

# 接收策略网页更新 · 2026-11-01

## 本版内容

- 恢复 `vendor/ds/b_receiver.py` 的原始LF字节，匹配既有1125案例RTL对照凭据；不修改凭据、模型逻辑或校验阈值。
- 增加软件预检：同时检查工作台外层清单、分析包内层清单和冻结模型凭据；换行回归、模型文件篡改仍被拒绝。
- 增加动态局部参考候选。对同一会话、同一实际接收配置，在14组候选都能比较且评分位数一致的共同窗口上，先最小化累计停止位错误上界，再最小化累计局部位错上界，保留并列候选。
- 共同有效窗口数为1至64均可输出局部参考；0块无候选。完整性错误、模型矛盾、UNKNOWN/未退役或分析取消等状态不被丢弃以制造推荐。
- 保留全64块候选及门槛区域的原规则；局部参考不补齐缺失块、不声称整图最优、不自动设置硬件参数，所有已评估ITEM仍统一比较同一组d/s。
- 网页及独立报告显示实际N/64、覆盖率和未参与块；局部候选放在全64块结论之前，同属参数结论区域。候选首行24px加粗，说明17px。
- JSON/CSV保存共同窗口范围及局部评分，继续提供原始波形、相位和表决点查看。

## 验证范围

本地两种安装形态的软件回归、动态数量及完整性分支测试、网页显示顺序/字号测试通过。网页HTTP到独立worker再到原生报告数据的链路，使用已归档真实session49验证；session5a已核对的局部窗口重算得到63/64块的d4/s=-2参考，缺口为第43块（ITEM索引42）。未为此更新新增硬件START。

后续收到的成功新SD session7原件已核对目标版本与ARM分析结果；同一版本绑定的fresh安装分支已合入正式主线。独立软件检查原报告文件的归档状态及各安装范围见fresh_sd_acceptance_20261101.md。

## 板侧更新

交付根目录附有 `GLITCHSCOPE_UI_DS_Display_20261101.zip` 和 `ui_ds_display_check_and_start.sh`。先在旧网页结束当前轮次，停止服务，再复制两文件到板侧项目目录运行脚本。脚本创建新目录、验证软件并绑定安装，不删除旧会话、不回写UNKNOWN、不自动发放额度，也不加载Overlay或发送START。

如果只检查源码，可运行 `python -B src/ps/workbench/software_check.py --output /outside/repository/check`。完整性清单必须与源码一致；不得手动改哈希来跳过模型凭据验证。

## 后续返回核验

2026-11-01收到同一fresh安装session7的完整原件：图片65条、64/64块ARM分析通过，任务授权版本与本显示修订包fresh分支匹配。原件与独立复算结论见fresh_sd_acceptance_20261101.md；独立软件检查报告文件尚未单独归档，原授权中报告哈希已保留。
