caoc30255-eng/glitchscope/build/reports/ax7010/export_inventory.txt

SOURCE_ROUTED_DCP=/path/to/glitchscope_source/AX7010_MultiPoint_Timing_v0_12_2026-10-17/build/route12_1792249299054/routed_mp12.dcp
BIT=/path/to/glitchscope_source/AX7010_MultiPoint_Timing_v0_12_2026-10-17/exports/candidate12_1792251179450/ax7010_multipoint_candidate_v0_12.bit BYTES=2083969 PURE_PL_NO_HWH_NO_ARM_APPLICATION
USER_REQUESTED_PARALLEL_CANDIDATE_EXPORT_NETLIST_SIMULATION_CONTINUES_SEPARATELY
FULL_MULTI_H1_START_AND_PS_MULTI_ADAPTER_PENDING_NO_BOARD_DOWNLOAD_NO_HARDWARE_ACCEPTANCE
