caoc30255-eng/glitchscope/hardware/enclosure/stl/stage_1_frame/05_adjustable_beam_qty2.stl

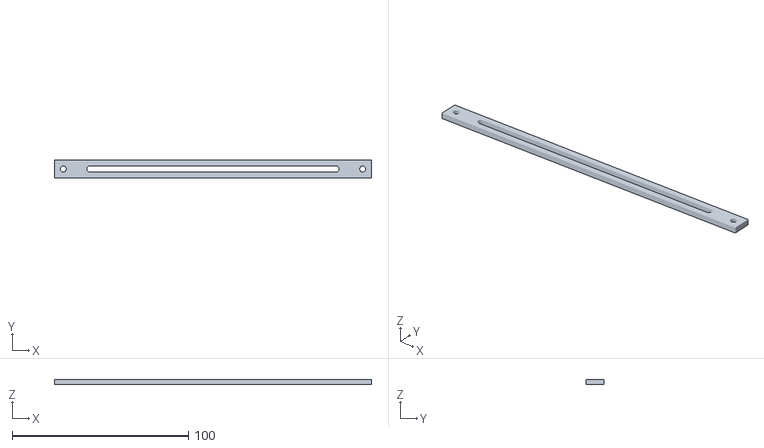
[picture p16: CAD file, 2026-11-02]
hardware/enclosure/stl/stage_1_frame/05_adjustable_beam_qty2.stl
180.0 x 10.0 x 3.00
