caoc30255-eng/glitchscope/hardware/enclosure/stl/stage_2_cover/06_rear_service_panel_qty1.stl

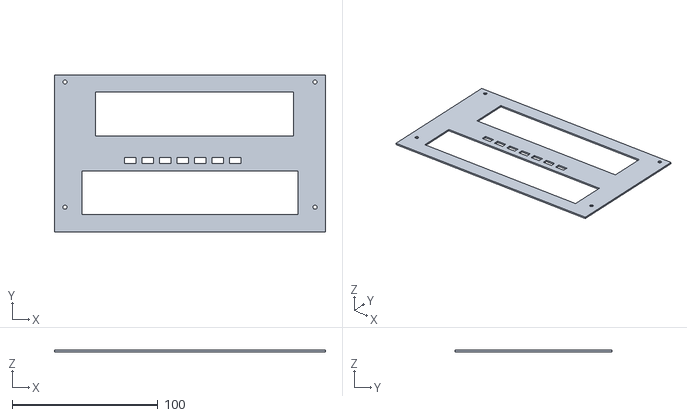
[picture p17: CAD file, 2026-11-02]
hardware/enclosure/stl/stage_2_cover/06_rear_service_panel_qty1.stl
186.0 x 107.8 x 1.20
