caoc30255-eng/glitchscope/hardware/enclosure/stl/stage_1_frame/06_foot_qty4.stl

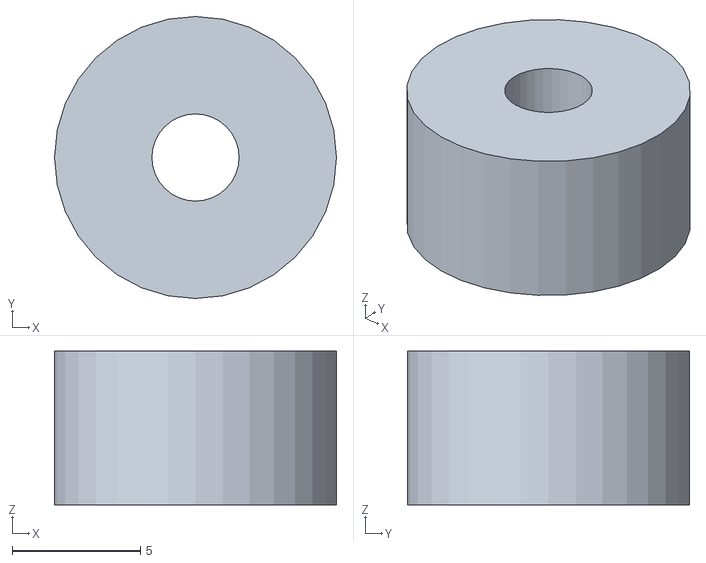
[picture p18: CAD file, 2026-11-02]
hardware/enclosure/stl/stage_1_frame/06_foot_qty4.stl
11.0 x 11.0 x 6.00
