caoc30255-eng/glitchscope/hardware/enclosure/stl/stage_2_cover/02_roof_corner_clip_qty4.stl

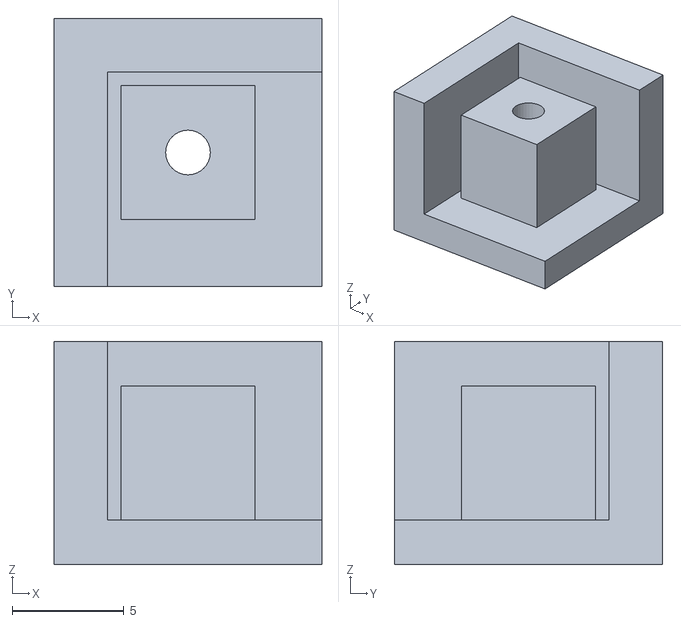
[picture p19: CAD file, 2026-11-02]
hardware/enclosure/stl/stage_2_cover/02_roof_corner_clip_qty4.stl
12.0 x 12.0 x 10.0
