caoc30255-eng/glitchscope/hardware/enclosure/stl/stage_1_frame/01_hole_coupon_qty1.stl

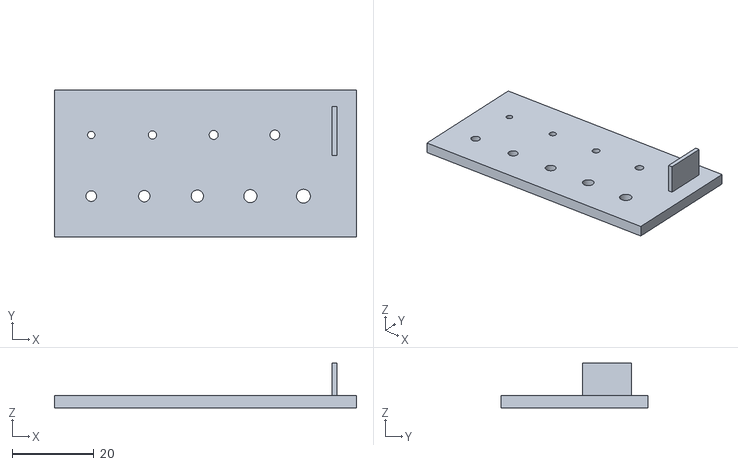
[picture p20: CAD file, 2026-11-02]
hardware/enclosure/stl/stage_1_frame/01_hole_coupon_qty1.stl
74.0 x 36.0 x 11.0
