caoc30255-eng/glitchscope/hardware/enclosure/stl/stage_1_frame/07_7020_edge_clamp_qty4.stl

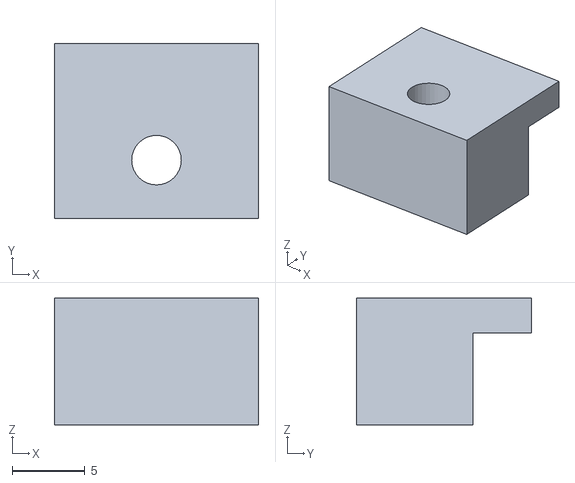
[picture p22: CAD file, 2026-11-02]
hardware/enclosure/stl/stage_1_frame/07_7020_edge_clamp_qty4.stl
14.0 x 12.0 x 8.70
