caoc30255-eng/glitchscope/hardware/enclosure/stl/stage_2_cover/07_roof_qty1.stl

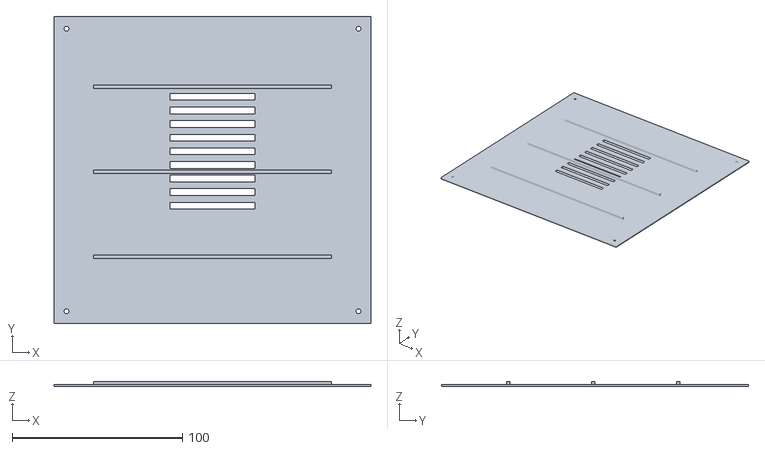
[picture p23: CAD file, 2026-11-02]
hardware/enclosure/stl/stage_2_cover/07_roof_qty1.stl
186.0 x 180.4 x 3.20
