caoc30255-eng/glitchscope/hardware/enclosure/stl/stage_1_frame/02_7020_acrylic_cradle_qty1.stl

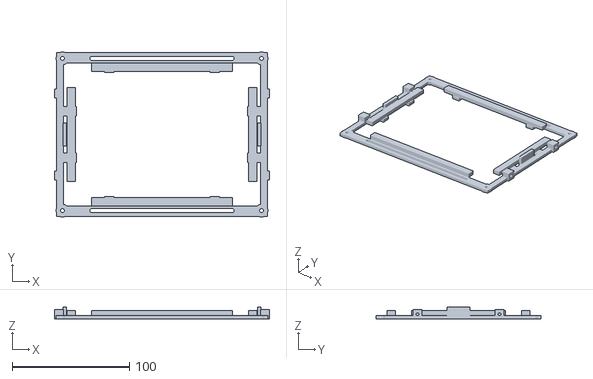
[picture p24: CAD file, 2026-11-02]
hardware/enclosure/stl/stage_1_frame/02_7020_acrylic_cradle_qty1.stl
183.6 x 141.0 x 10.0
