caoc30255-eng/glitchscope/hardware/enclosure/stl/stage_1_frame/04_7010_upper_frame_qty1.stl

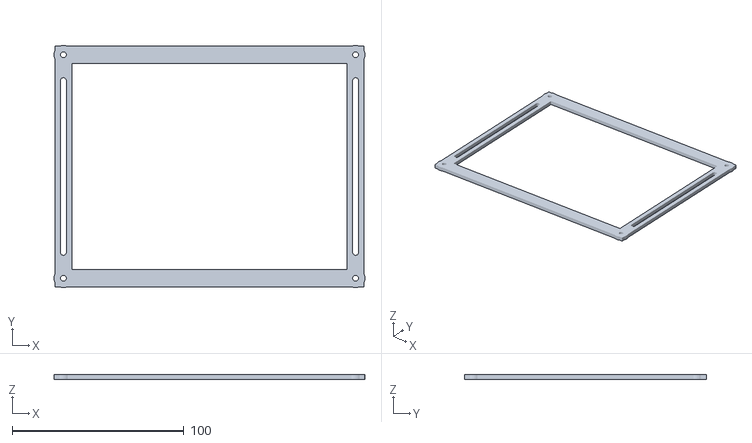
[picture p26: CAD file, 2026-11-02]
hardware/enclosure/stl/stage_1_frame/04_7010_upper_frame_qty1.stl
181.0 x 141.0 x 3.00
