caoc30255-eng/glitchscope/hardware/enclosure/stl/stage_1_frame/03_load_column_qty4.stl

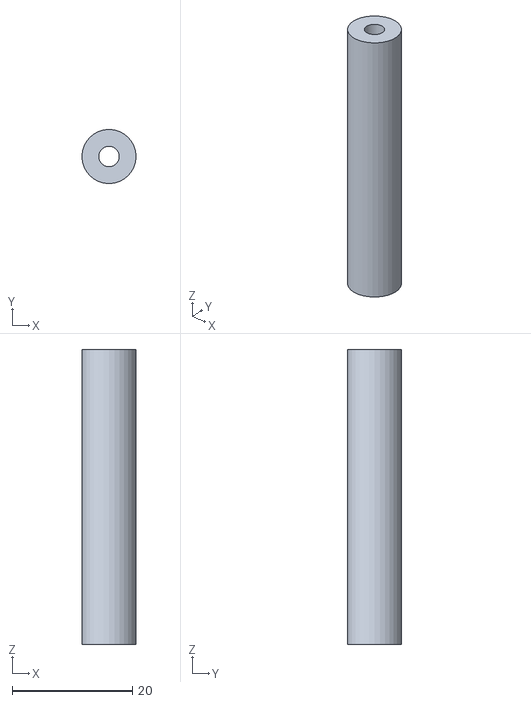
[picture p28: CAD file, 2026-11-02]
hardware/enclosure/stl/stage_1_frame/03_load_column_qty4.stl
9.00 x 9.00 x 49.0
