caoc30255-eng/glitchscope/hardware/enclosure/stl/stage_2_cover/03_left_panel_qty1.stl

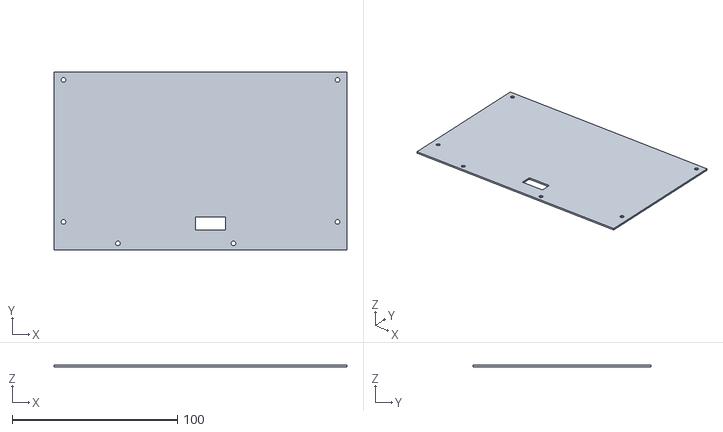
[picture p29: CAD file, 2026-11-02]
hardware/enclosure/stl/stage_2_cover/03_left_panel_qty1.stl
177.5 x 107.8 x 1.20
