caoc30255-eng/glitchscope/hardware/enclosure/print_instructions.txt

GLITCHSCOPE：保留两块原亚克力的完整试装方案 v16
2026-10-28。本包替代此前打印方案。旧包不要混用。

一、最终采用的结构
下层7020保留原背面亚克力、原铜柱、喇叭及螺钉，整套放在新底托上。
底托只承托亚克力边缘，中间镂空，四角螺钉避让。前后四个压块沿长槽移动，找背面没有焊脚/器件的位置，压住亚克力而不是PCB；接触处加薄软垫，按试配选厚度。左右定位面净宽163mm，前后压块外侧定位净距约122mm，留直尺估测余量，用软垫调节松紧。压块不得顶住PCB、焊脚或原螺钉。

上层7010保留正面亚克力、原铜柱和顶部螺钉。优先逐角将背面原螺母换成配套的10mm内螺纹隔离柱，再从可调梁下方用同规格螺钉固定；若原件是底部内牙铜柱，则按第三节选择上外牙、下内牙的公母柱。
连接顺序：护板—原铜柱—PCB—新增10mm隔离柱—可调安装梁—下方固定螺钉。
两根梁在框架上前后移动，四个PCB固定点在梁槽上左右移动；锁定后由四根独立承重支柱传到底托，不让7020 PCB承受上层重量。

外罩：左右、前后、顶盖共五块1.2mm PETG打印面板；顶盖带加强筋。接口保留服务窗口，位置和插头外形尚未精密测量；可拆面板便于单独修改，不把示意接口当精确开孔图。
不装风扇，保留被动通风。是否能长期无风扇须在最终负载下测温验证。

二、尺寸口径（毫米）
用户给的是直尺估测，不能当作卡尺或装配通过证明。
7020：原亚克力160×120×2；PCB下表面至亚克力底面8；元件最高14；底部螺钉突出2。
7010：原护板129×89×2.8；PCB上表面至顶部螺钉头19；背面突出4.5。
PCB厚1.6仍是设计假设。护板厚度已包含在原组件高度中，不重复相加。
设计外形约186×180.4×115.2（不计伸出五金/插头）。7020 PCB底面Z15，7010 PCB底面Z68，层间底面距离53。
7010梁顶Z58，新增隔离柱10mm，背面突出物名义余量5.5mm。原顶部铜柱和护板不用重新购买；模型中的孔位、缺口和喇叭外形仍为示意。
7020原底部螺钉最低Z5，比底架平面Z3高2mm；角部避让区需实际检查。压块顶部接近PCB背面，必须沿槽选无器件位置，不可强行压紧。

三、先配五金，再开打印订单
先带一颗原背面紧固件或铜柱，到五金店配一个主体长10mm的隔离柱试拧。原螺纹未核实，不要直接认定M3。
原柱有伸出PCB的外螺杆：选双通内螺纹柱，替换背面原螺母。
若拆下的是螺钉、原柱底端为内螺纹：选上外牙/下内牙的公母隔离柱，上端穿过PCB接原柱，下端从梁下面锁螺钉。需核对上端外牙长度，不能在原柱内顶死后还未夹紧PCB。
两种方式的新柱主体均为10mm；图中按第一种画出，并不代表已核实原件牙型。
新柱上端须能拧牢原螺杆，下端螺钉穿过3mm安装梁和垫圈后仍有有效咬合；两端螺杆不能在柱内顶住。按实际原螺杆长度和柱内孔深选下方螺钉，图中长度不作为采购尺寸。每根新柱的两端都须有效锁紧，不能靠螺杆互相顶住来制造“拧紧”的假象。
确认一个能配合后再配齐4个。隔离柱是成品金属或绝缘五金，不是打印件。

五金清单：
1. 主体长10mm的隔离柱4个，双通或公母按原件牙型选择；匹配的梁下螺钉4颗及垫圈，均与原螺纹配套。
2. 主支柱贯穿连接：M3×70候选，4套，带螺母/垫圈，长度须试装。
3. 可调梁固定：M3×12候选，4套，带螺母/垫圈。
4. 7020压块固定：M3×16候选，4套，带螺母/垫圈。
5. 四块立面板：M2.5自攻约5mm，20颗，带垫圈；顶盖M2.5自攻约8mm，4颗，带垫圈。先用试片检查孔径；不可强拧或拧穿PCB空间。
6. 少量薄软垫，用于亚克力与底托/压块接触处。厚度按试装调整，不把直尺估测的2mm厚度锁死。

四、给打印店的要求
PETG、0.4mm喷嘴候选，平台至少220×220。单位毫米，100%原尺寸，禁止等比缩放。店家负责切片。
STL已按拟平放方向导出，文件名标注数量，按数量打印。共13种29个装机打印件，另有1个孔径试片；两块原亚克力和金属柱不打印。
建议0.2mm层高，结构件3–4道墙、20–30%填充作为起点；1.2mm面板必须形成连续壁。顶盖外面朝下，加强筋朝上。支撑、桥接和大面板防翘边由店家逐层确认，不提供通用G-code。
本模型全实心PETG装机打印件约233.6g，未计试片、支撑、裙边、五金、原亚克力和板卡。实际报价与耗材以店家切片为准。

五、打印和装配顺序
第一步：配对上面所述一个隔离柱，并先打印孔径试片1个（大孔沿X依次2.6/2.8/3.0/3.2/3.4mm，小孔依次1.8/2.0/2.2/2.4mm）。确认螺纹和打印孔配合。
第二步：打印第一组其余内架件。底托装四个底脚，放入7020整套组件，调整四个压块，确认亚克力放平、喇叭/焊脚/原角螺钉均不接触打印件。
第三步：安装四根承重支柱和上层框、两根可调梁。逐角更换7010背面螺母为新柱，托住护板，不让原铜柱松脱；调整梁后从下方锁住四个新柱。
第四步：插上实际网线、USB、电源和板间线束，检查TF卡插拔、按键、插头锁扣和背面器件间隙。螺钉不得伸出顶碰PCB，PCB不得翘曲。
第五步：内架实际通过后，再打印第二组外罩。装连接角、侧板和前后板，最后装顶盖。两组中已经打印的件不重复下单。
第六步：在最终演示负载下检查温度和运行稳定性，无风扇效果尚未验收。

六、仍需实物确认
本包是完整试装方案，不是实物已验收的量产定稿。
若不合适，只改对应内架或面板，不强装、不粘死、不先把两组全部打印。
