caoc30255-eng/glitchscope/report/llm_interactions_original/cases/case02_wiring_and_fresh_sd.md

# 图片波形校验失败、新旧SD对照与固线后复现

本文件为事后整理的案例导读，不是重写后的原始对话。原始消息编号可在独立评审记录包中定位。

## 问题

图片任务在毛刺宽度校验处停止，短暂恢复点总与MARK下降沿接近；UNKNOWN不能改写为成功。

## 操作者的作用

操作者提供原始任务包、快照、新旧SD对照，并现场重新固定接线；对“只是相位37未覆盖”的解释提出疑问。

## 模型与工具的迭代

保全快照，检查正序/倒序读取，核对旧成功参数；发现原卡也复现，撤回把问题简单归于新卡迁移或未测相位的解释。诊断采集器还修复了MMIO实例绑定write方法的兼容错误。

## 结果

固线后完整图片任务通过；随后fresh_runs/session7完成65条、多路CRC恢复整图SHA一致，并完成64/64块ARM分析。

## 结论边界

根因定位中的推测和最终现场确认分开，旧UNKNOWN保留；新旧SD不同部署目录不互相冒充。

## 原始记录定位

### m04594 · user · 2026-10-31T12:26:37.098000+00:00

评审包内路径：`raw/dialogue_20261031.md#m04594`。

### m04626 · user · 2026-10-31T13:01:36.842000+00:00

评审包内路径：`raw/dialogue_20261031.md#m04626`。

> 我们之前传输图片为什么没问题

### m04673 · user · 2026-10-31T15:06:17.716000+00:00

评审包内路径：`raw/dialogue_20261031.md#m04673`。

> 已经确定是线不稳定导致的

### m04676 · user · 2026-10-31T15:47:40.201000+00:00

评审包内路径：`raw/dialogue_20261031.md#m04676`。

> 新sd卡成功 重新固定接线了

### m04679 · assistant · 2026-10-31T15:50:03.053000+00:00

评审包内路径：`raw/dialogue_20261031.md#m04679`。

> **这次图片传输与修复通过，重新固定接线后的完整运行已验证成功。**
> 
> - 会话：`session_0000005a`
> - **65条全部完成，UNKNOWN为0**
> - 接收器和锁正常释放，无清理错误
> - 我用**未放宽的校验函数**复查64份已保存毛刺波形，全部通过
> 
> 修复结果：
> 
> | 数据／方法 | 错误像素数 | 整图SHA验证 |
> |---|---:|---|
> | B原始接收 | 1,820 | — |
> | 仅B的CRC突发修…

### m04720 · user · 2026-11-01T01:52:25.549000+00:00

评审包内路径：`raw/dialogue_20261101.md#m04720`。

> 新卡ds以及图片都成功

## 工程验证关联

- `docs/fresh_sd_acceptance_20261101.md`
- `report/verification/ui_software/fresh_sd_session7_20261101.json`
- 独立原始实验包：`submission_evidence/fresh_sd_session7_20261101.zip`。
