caoc30255-eng/glitchscope/hardware/enclosure/assembly_guide.html

GLITCHSCOPE / 装配指南v16 · 保留原亚克力 · 7020下层 / 7010上层

断电装配 · 先内架，后外罩

拖动旋转 · 滚轮缩放 · 右键平移

彩色显示当前步骤 · 灰色为已装部件

3D加载失败。右侧螺钉图仍可使用，请用支持WebGL的桌面浏览器打开。

斜视俯视从下往上看正视仅看7010连接显示后续零件自动旋转

装合拆开看45%

← 上一步下一步 →

右侧为原理剖面示意，非加工图；3D位置不代表原板安装孔已精测。离线可用，不连接任何板卡。

## 螺钉怎么装

分解顺序与穿入方向 · 不按比例

原柱伸出螺杆：双通柱原柱底部内牙：公母柱
