caoc30255-eng/glitchscope/hardware/measured_enclosure_fit/README.md

# v16 外壳实物装配记录

2026-11-02归档。共8张原始实拍图，未裁剪、调色或重绘；英文文件名只用于交付整理。拍摄日期未独立核验，归档日期不代表拍摄日期。

## 装配检查结果

**装配及人工配合检查通过。**依据为用户提供的8张实拍图及实际装配检查反馈：

> 无修改  无顶碰无松动 正常插拔 一切完好

按本轮提问范围，正常插拔包括网线、电源和USB。打印件未进行扩孔、打磨或切割；未反馈顶碰或松动。以上为实际装配检查反馈。

照片展示v16外壳完成状态、7010在上/7020在下、保留原亚克力、安装梁及螺钉、接口窗口和线束；STM32仍在壳外。图8是通电与网页工作台展示，不单独用作三项功能验收凭据。

## 查看文件

- `index.html`：双击打开照片目录与逐图说明，无需联网。
- `photos/`：8张原始照片，像素内容与用户提供文件一致。
- `photo_manifest.json`：原文件名、交付文件名、字节数和SHA-256。
- `assembly_check.json`：装配检查结论、实际反馈原文和验证范围。

本目录不再列为应为空的缺项目录；设计报告等其他约定空目录保持原状态。
