caoc30255-eng/glitchscope/report/verification/clock_reference/README.md

# 时钟核对证据

board_readonly_excerpt.json摘录本次板侧完整输出中的相关字段，并明确来源；不伪称仪器测量。timing_review.json保留原路由100MHz与假设150MHz的静态对照，约100MHz当前推算口径见docs/clock_reference.md。原始历史报告不改写。本轮未修改硬件配置。
