caoc30255-eng/glitchscope/build/fresh_reproduction_results/README.md

# 复现证据

范围及剩余步骤见 docs/fresh_reproduction.md。这里是实际分阶段本地执行结果，不是最终PYNQ部署/干净SD卡验收证明。历史原件和既有固件保持不变。
