caoc30255-eng/glitchscope/skill/verification_matrix.md

# 自动能力与外部验证矩阵 v1.1

|项|已自动检查/已运行|仍需人工或外部验证|
|---|---|---|
|PYNQ预检|mask非零、资产SHA、HWH映射、读副作用声明、写入范围门禁、前后时钟配置读回字段、机器/Python/PYNQ/DT信息|寄存器手册正确性、HWH与实际位流对应、物理时钟、具体板卡真实性；本轮硬件阶段仅假设备测试|
|AXI契约|字段完整覆盖/重叠/写常量、普通/混合RMW、W1C/读清零/脉冲模型、HWH绑定的MMIO示例门禁|AXI时序响应、CDC、其他主设备竞争、实际scratch安全、实板MMIO入口验收|
|RTL参考|Vivado2026.1编译/展开/仿真，384周期对照，注入背压bug被拒；分块SHA、周期计数、X/Z和截断|自己的参考模型正确性、综合和实现时序、真实硬件；不借此声称FCLK150签核|
|实验证据|哈希链/文件、UNKNOWN占用、原始坏帧留存、H5E1 READ32回执、peer生命周期次序、跨进程合作租约、关闭未确认隔离；增量结束全审计|实际namespace和权限来源、未合作进程、native线程存活、原owner的本地TX_DONE/READY与严格退役；本轮对端非板卡|
|模型一致性|实际工件加载钩子、不可变参数预测、C99双实现、改变参数后的对照、逐字段容差/量纲声明、精确状态类型；计时明确为predict调用|量纲/容差选择、准确率/校准/泛化、任意runner内部IO、真正ARM/其他部署器验证；文件绑定不等于内存认证|
|有界策略|选择前前缀、预算、重复组、UNKNOWN停止和原件钩子、真实帧/账本组合；30轮/策略独立模拟、Wilson和campaign级配对bootstrap|真实噪声代表性、真实多轮对照和因果归因、独立迁移；模拟区间不证明AI硬件优越|

默认路径不会连接板卡。显式真实MMIO/transport接口只有在用户已允许相应动作且适配器准备好时才使用；flag本身不是自动审批。

## 后续跨板实验更新

六项Skill均通过AX7010跨板实验验证。该结果更新此前跨板待验状态，详见 verification/cross_board_experiment.json。原155项测试及既有日志保持原样；未提供新增原始实测日志。新操作者独立复现与各项其他验证边界不因此自动通过。

## v1.2 新增时钟一致性项

|已自动检查/实跑|范围和未覆盖项|
|---|---|
|40项离线检查；两板只读输出；通用图和未知平台软件发现CLI|两板原始采集为Zynq7000；其他平台需审查适配或导出规范化图，未提供任意芯片原始地址采集。结论为配置推算，配置修改需另行授权。AX7010约10ppm声明差异保留人工复核。|
