caoc30255-eng/glitchscope/skill/pynq-bringup/references/cases.md

# 失败来源与排查决策

|来源|观察|迁移后的规则|本轮如何验证|
|---|---|---|---|
|PYNQ shell启动Overlay|普通用户和root均No Devices Found，加载同一shell系统/厂商环境后发现设备|权限与运行环境分开检查，不把提权作为充分条件|离线不导入PYNQ；fake设备阶段单独验证环境门槛及下载前置条件|
|session26 Notebook保存|格式/换行变化触发旧逐字文本检查|固定资产仍精确哈希；Notebook代码按AST和单元格顺序校验|格式/注释通过，值变化/多代码单元格失败|
|多内核操作|flock被旧内核占用|查明并正常关闭占用者，不删除锁文件来声称已释放|本项不实现全局锁；调用方负责，证据技能也不替代OS锁|

记录的历史命令和路径只用于说明来源；不要把旧路径或旧软件PASS凭据复制到新工程冒充新验证。IPython `%`/`!`语句需单独制定语义校验，工具明确拒绝解析失败，不静默剥离。
