caoc30255-eng/glitchscope/hardware/measured_enclosure_fit/index.html

# GLITCHSCOPE · v16实物装配记录

8张原始照片 · 2026-11-02归档 · 点击照片查看原图

装配及人工配合检查通过

实际装配反馈：打印件无修改，无顶碰、无松动，网线、电源及USB正常插拔。

依据：原始照片与用户实际检查反馈。

说明 · 检查记录 · 照片校验清单

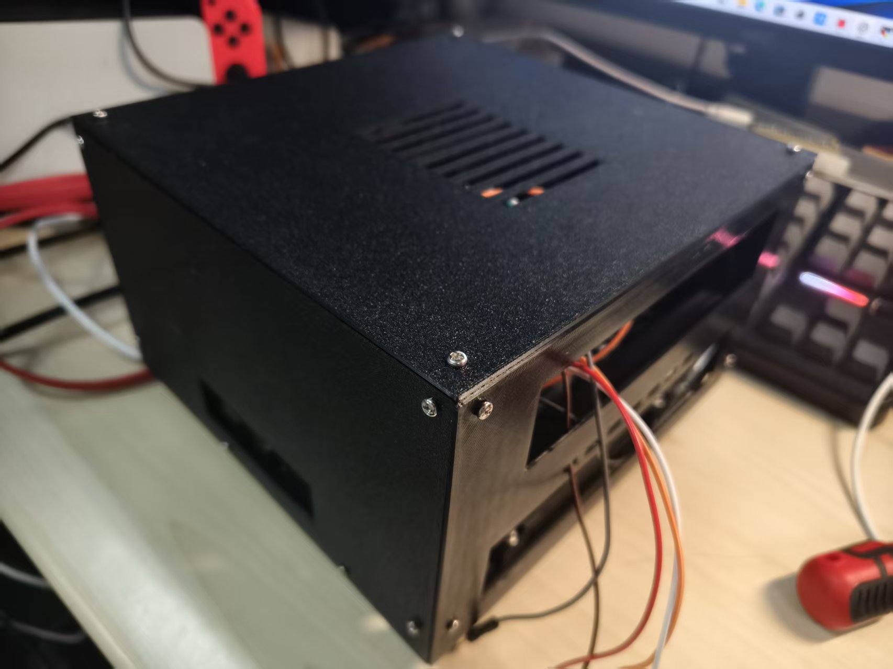
[picture p30: hardware/measured_enclosure_fit/photos/01_assembled_top_oblique.jpg]
总装斜视一


总装斜视一

外罩、顶盖通风槽、面板螺钉及引出线。

photos/01_assembled_top_oblique.jpg

总装斜视二

总装斜视二

外壳完成状态、顶盖与相邻面板。

photos/02_assembled_overview.jpg

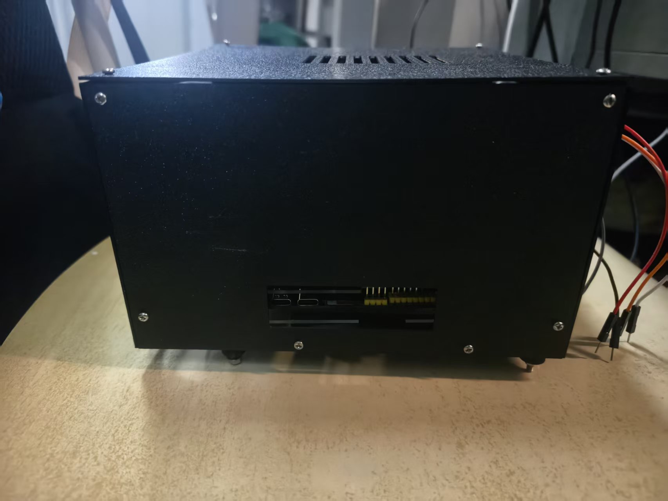
[picture p31: hardware/measured_enclosure_fit/photos/03_side_interface_window.jpg]
侧面接口窗口


侧面接口窗口

侧面开口与下层板卡接口。

photos/03_side_interface_window.jpg

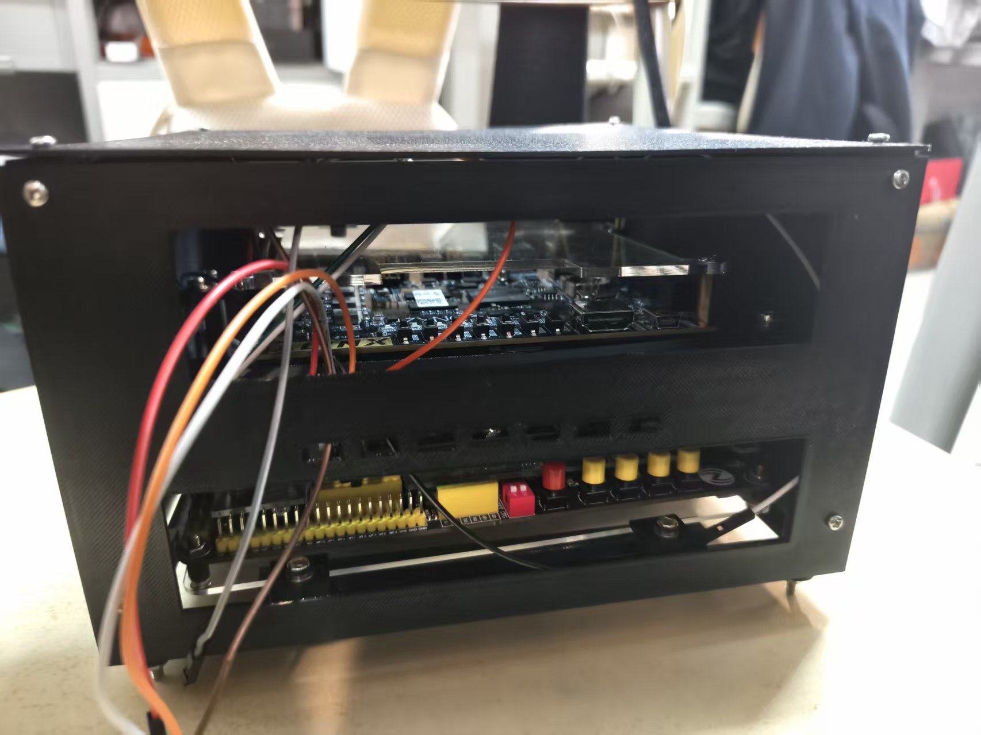
[picture p32: hardware/measured_enclosure_fit/photos/04_board_stack_and_wiring.jpg]
双层板卡与引出线


双层板卡与引出线

上下叠放布局、亚克力与外引线束。

photos/04_board_stack_and_wiring.jpg

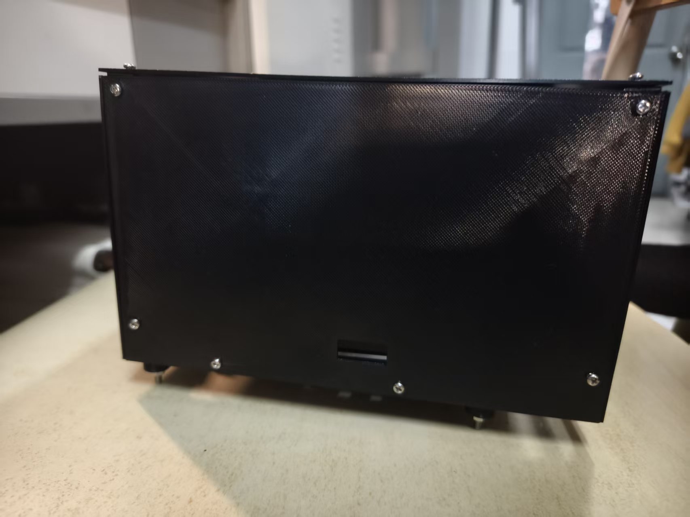
[picture p33: hardware/measured_enclosure_fit/photos/05_opposite_side_panel.jpg]
另一侧面板


另一侧面板

面板固定、下部开口及底脚。

photos/05_opposite_side_panel.jpg

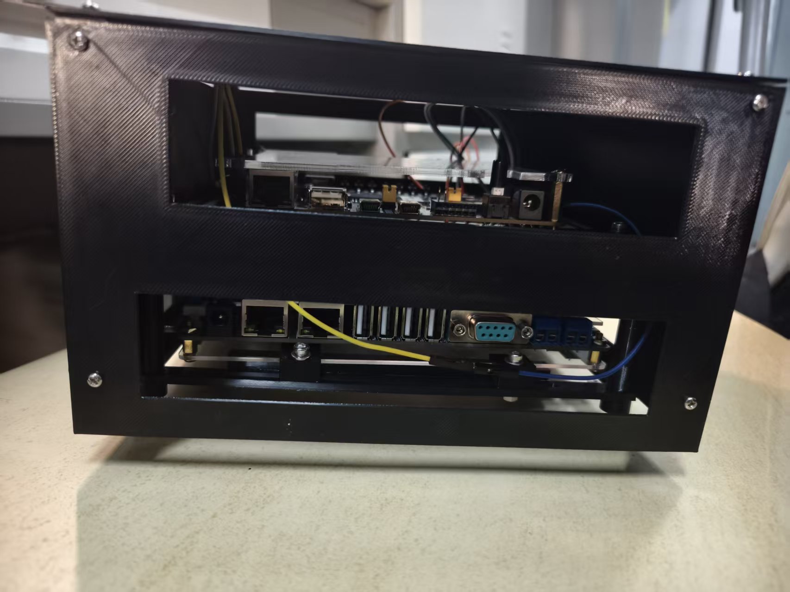
[picture p34: hardware/measured_enclosure_fit/photos/06_rear_ports_and_mounts.jpg]
双层接口与下层固定


双层接口与下层固定

上层7010与下层7020接口窗口、下层亚克力及压块可见。

photos/06_rear_ports_and_mounts.jpg

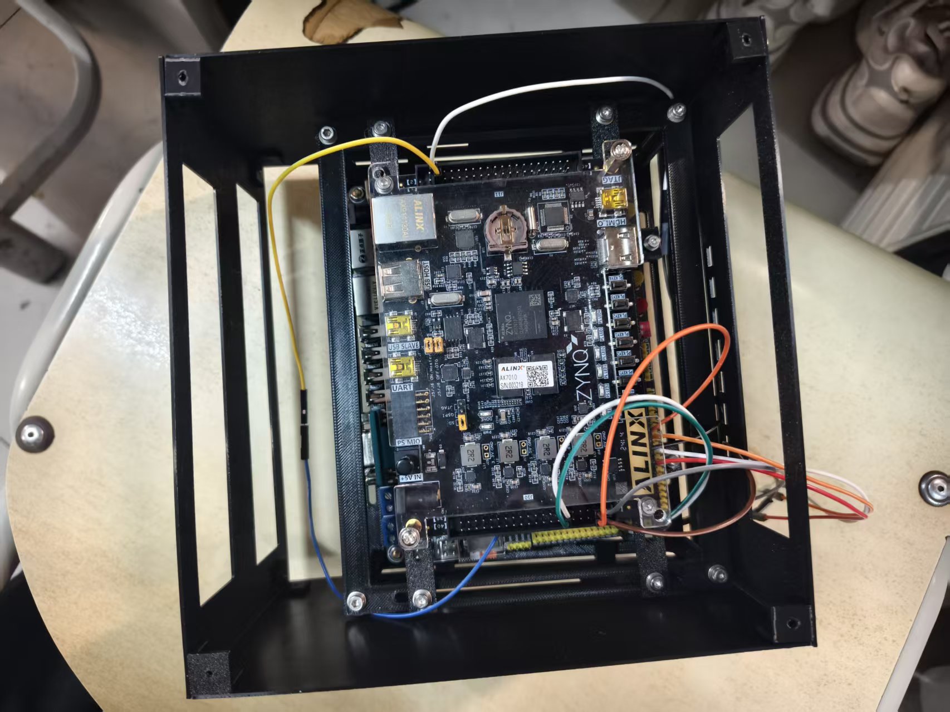
[picture p35: hardware/measured_enclosure_fit/photos/07_open_top_upper_mount.jpg]
拆盖内部布局


拆盖内部布局

上层AX7010、安装梁、螺钉和线束；下层板卡被部分遮挡。

photos/07_open_top_upper_mount.jpg

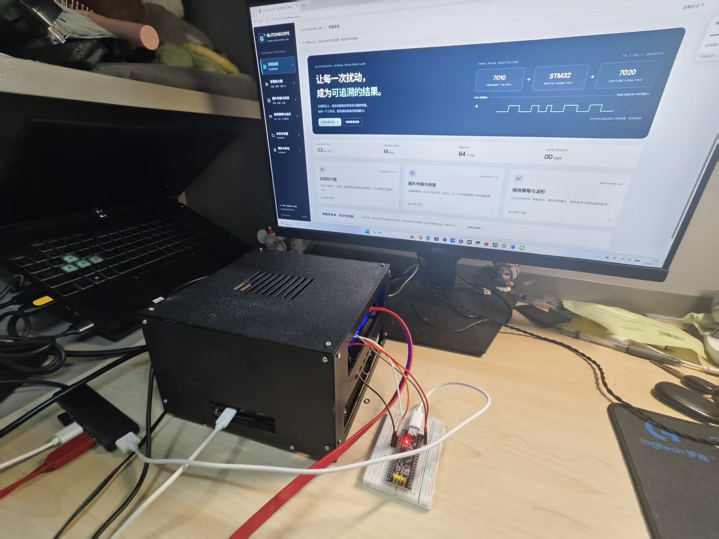
[picture p36: hardware/measured_enclosure_fit/photos/08_powered_workbench_setup.jpg]
通电展示环境


通电展示环境

外壳装置、壳外STM32、电脑及网页工作台；此照片本身不证明全部功能验收。

photos/08_powered_workbench_setup.jpg
