caoc30255-eng/glitchscope/skill/rtl-reference-cosim/references/current_validation/injected_reference.csv

case | cycle | ready | valid | data | acc
0 | 0 | 1 | 0 | 0 | 0
0 | 1 | 1 | 0 | 0 | 0
0 | 2 | 1 | 1 | 14 | 14
0 | 3 | 1 | 0 | 14 | 14
0 | 4 | 1 | 1 | 42 | 42
0 | 5 | 1 | 1 | 77 | 77
0 | 6 | 1 | 0 | 77 | 77
0 | 7 | 1 | 1 | 126 | 126
0 | 8 | 1 | 1 | 182 | 182
0 | 9 | 1 | 0 | 182 | 182
0 | 10 | 1 | 1 | 252 | 252
0 | 11 | 1 | 1 | 73 | 73
0 | 12 | 1 | 0 | 73 | 73
0 | 13 | 1 | 1 | 164 | 164
0 | 14 | 1 | 1 | 6 | 6
0 | 15 | 1 | 0 | 6 | 6
0 | 16 | 1 | 1 | 118 | 118
0 | 17 | 1 | 1 | 237 | 237
0 | 18 | 1 | 0 | 237 | 237
0 | 19 | 1 | 1 | 114 | 114
0 | 20 | 1 | 1 | 254 | 254
0 | 21 | 1 | 0 | 254 | 254
0 | 22 | 1 | 1 | 152 | 152
0 | 23 | 1 | 1 | 57 | 57
0 | 24 | 1 | 0 | 57 | 57
0 | 25 | 1 | 1 | 232 | 232
0 | 26 | 1 | 1 | 158 | 158
0 | 27 | 1 | 0 | 158 | 158
0 | 28 | 1 | 1 | 98 | 98
0 | 29 | 1 | 1 | 45 | 45
0 | 30 | 1 | 0 | 45 | 45
0 | 31 | 1 | 1 | 6 | 6
0 | 32 | 1 | 1 | 230 | 230
0 | 33 | 1 | 0 | 230 | 230
0 | 34 | 1 | 1 | 212 | 212
0 | 35 | 1 | 1 | 201 | 201
0 | 36 | 1 | 0 | 201 | 201
0 | 37 | 1 | 1 | 204 | 204
0 | 38 | 1 | 1 | 214 | 214
0 | 39 | 1 | 0 | 214 | 214
0 | 40 | 1 | 1 | 238 | 238
0 | 41 | 1 | 1 | 13 | 13
0 | 42 | 1 | 0 | 13 | 13
0 | 43 | 1 | 1 | 58 | 58
0 | 44 | 1 | 1 | 110 | 110
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
