caoc30255-eng/glitchscope/src/stm32/tests/vectors/normal64/preview.png

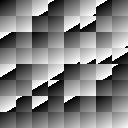
src/stm32/tests/vectors/normal64/preview.png
