caoc30255-eng/glitchscope/docs/release_notes.md

# 发行说明

## 当前发行内容 · 2026-11-02

本发行包含正式实板工作台、两块FPGA源码与固件、STM32 DUT工程、原生接收库源码、七项技能、复现入口、验证资料、v16外壳以及实物装配照片。

### 软件与功能

- 保留已验证的实验编排、记录额度、独立会话、停止与资源关闭机制。
- 接收策略页面支持动态N/64共同窗口局部参考，保留完整性检查、全64候选门槛和实际接收结果。
- 正式工作台版本清单与新SD成功session7绑定一致，包含新安装初始化、安装状态与设备访问锁适配。
- 模型冻结凭据、字节校验及原始实验状态保持可核对；展示摘要和原始证据分别保存。

### 工程与外壳

- 提供7010/7020构建入口、STM32构建入口及板端软件/原生库复现入口。
- v16采用7020下层、7010上层布局，保留原亚克力，附14种打印STL、数量清单、OpenSCAD源文件和交互装配指南。
- 归档8张原始实拍及实际装配反馈：打印件无修改、无顶碰无松动，网线、电源及USB正常插拔。

### 验证资料

|范围|记录|
|---|---|
|核心功能|report/verification中的扫描、图像恢复、接收策略与边缘AI记录|
|目标板软件|Python3.8/armv7l软件检查、原生库构建与导出符号核对|
|新SD首次部署|首次0记录初始化、成功session7图片65条与64/64窗口分析|
|技能|v1.2.1七项、195项离线回归凭据及对应分层实测|
|协作记录|26页、22案例阅读版、原文来源与缺口索引|
|时钟|参考值与寄存器配置推算约100MHz，详见clock_reference.md|

具体数据、来源和验证范围以各项报告为准。新SD原授权中保留软件检查报告的哈希，独立报告原文件的归档状态见fresh_sd_acceptance_20261101.md。局部候选评分不替代配置后的硬件验证；原始失败和UNKNOWN保持原状态。

## 主要版本节点

- 2026-10-27：正式工作台及三板工程整理。
- 2026-10-28：工程技能示例与契约、账本及一致性验证完善。
- 2026-10-29：时钟一致性排查技能、构建修复和复现入口合入。
- 2026-11-01：动态局部参考、成功新SD分支、协作记录及v16模型合入。
- 2026-11-02：实物装配照片归档与当前交付文档统一。

本轮交付文档整理不改变运行代码、模型权重、固件、STL几何或原始验证文件。早期内部整理稿保存在提交目录外的历史备份中。正式提交材料的状态统一见根目录submission_checklist.md。
