caoc30255-eng/glitchscope/src/pl/ax7020/rtl/h1_7020_ch1_mapping_top_v0_4.v

`timescale 1ns/1ps
// Four AXI slaves, saved H1 tuple completion and actual CH1 cache retirement.
// Mapping sideband is owner-provided; all blocks share a clock/reset.
module h1_7020_ch1_mapping_top_v0_4 #(
 parameter integer JOURNAL_DEPTH=1024, IDLE_GUARD_TICKS=10000, INTERBYTE_TICKS=200000,
 CLK_HZ=100000000, BAUD=1000000, H1_BAUD=2000000
)(
 input wire clk,rst_n,uart_rx,h1_rx_pin,
 output wire h1_tx_pin,physical_done,
 output wire [255:0] done_identity,




 output wire matcher_fault,mapping_fault,
 output wire [31:0] matched_count,
 output wire matcher_active,matcher_done,
 input wire external_fault,session_can_retire,
 output wire fault_latched,record_active,record_valid,aux_pending,retired_take,
 output wire [15:0] raw_count,
 output wire [7:0] terminal_reason,
 output wire [31:0] retire_count,evidence_epoch,
 output wire [63:0] tick,
 input wire [13:0] main_awaddr,
 input wire  main_awvalid,
 output wire  main_awready,
 input wire [31:0] main_wdata,
 input wire [3:0] main_wstrb,
 input wire  main_wvalid,
 output wire  main_wready,
 output wire [1:0] main_bresp,
 output wire  main_bvalid,
 input wire  main_bready,
 input wire [13:0] main_araddr,
 input wire  main_arvalid,
 output wire  main_arready,
 output wire [31:0] main_rdata,
 output wire [1:0] main_rresp,
 output wire  main_rvalid,
 input wire  main_rready,
 input wire [11:0] aux_awaddr,
 input wire  aux_awvalid,
 output wire  aux_awready,
 input wire [31:0] aux_wdata,
 input wire [3:0] aux_wstrb,
 input wire  aux_wvalid,
 output wire  aux_wready,
 output wire [1:0] aux_bresp,
 output wire  aux_bvalid,
 input wire  aux_bready,
 input wire [11:0] aux_araddr,
 input wire  aux_arvalid,
 output wire  aux_arready,
 output wire [31:0] aux_rdata,
 output wire [1:0] aux_rresp,
 output wire  aux_rvalid,
 input wire  aux_rready,
 input wire [11:0] ctrl_awaddr,
 input wire  ctrl_awvalid,
 output wire  ctrl_awready,
 input wire [31:0] ctrl_wdata,
 input wire [3:0] ctrl_wstrb,
 input wire  ctrl_wvalid,
 output wire  ctrl_wready,
 output wire [1:0] ctrl_bresp,
 output wire  ctrl_bvalid,
 input wire  ctrl_bready,
 input wire [11:0] ctrl_araddr,
 input wire  ctrl_arvalid,
 output wire  ctrl_arready,
 output wire [31:0] ctrl_rdata,
 output wire [1:0] ctrl_rresp,
 output wire  ctrl_rvalid,
 input wire  ctrl_rready,
 input wire [11:0] h1_awaddr,
    input wire h1_awvalid,
    output wire h1_awready,
    input wire [31:0] h1_wdata,
    input wire [3:0] h1_wstrb,
    input wire h1_wvalid,
    output wire h1_wready,
    output wire [1:0] h1_bresp,
    output wire h1_bvalid,
    input wire h1_bready,
    input wire [11:0] h1_araddr,
    input wire h1_arvalid,
    output wire h1_arready,
    output wire [31:0] h1_rdata,
    output wire [1:0] h1_rresp,
    output wire h1_rvalid,
    input wire h1_rready,
 output wire owner_fault,
 input wire [11:0] map_awaddr,
 input wire map_awvalid,
 output wire map_awready,
 input wire [31:0] map_wdata,
 input wire [3:0] map_wstrb,
 input wire map_wvalid,
 output wire map_wready,
 output wire [1:0] map_bresp,
 output wire map_bvalid,
 input wire map_bready,
 input wire [11:0] map_araddr,
 input wire map_arvalid,
 output wire map_arready,
 output wire [31:0] map_rdata,
 output wire [1:0] map_rresp,
 output wire map_rvalid,
 input wire map_rready
);
 wire mapping_valid,actual_arm,status_backlog;
 wire [31:0] mapping_epoch,mapping_peer_epoch,mapping_record_id;
 wire [255:0] mapping_identity;
 wire [15:0] mapping_inner_crc;
 wire [31:0] actual_record_id,actual_retired_epoch,actual_retired_record_id;
 wire [255:0] actual_identity,actual_retired_identity;
 h1_7020_ch1_saved_completion_top_v0_5 #(.JOURNAL_DEPTH(JOURNAL_DEPTH),
 .IDLE_GUARD_TICKS(IDLE_GUARD_TICKS),.INTERBYTE_TICKS(INTERBYTE_TICKS),.CLK_HZ(CLK_HZ),.BAUD(BAUD),.H1_BAUD(H1_BAUD)) core(
.actual_arm(actual_arm),
.status_backlog(status_backlog),
.actual_record_id(actual_record_id),
.actual_retired_epoch(actual_retired_epoch),
.actual_retired_record_id(actual_retired_record_id),
.actual_identity(actual_identity),
.actual_retired_identity(actual_retired_identity),
.clk(clk),
.rst_n(rst_n),
.uart_rx(uart_rx),
.h1_rx_pin(h1_rx_pin),
.h1_tx_pin(h1_tx_pin),
.physical_done(physical_done),
.done_identity(done_identity),
.mapping_valid(mapping_valid),
.mapping_epoch(mapping_epoch),
.mapping_peer_epoch(mapping_peer_epoch),
.mapping_record_id(mapping_record_id),
.mapping_identity(mapping_identity),
.mapping_inner_crc(mapping_inner_crc),
.matcher_fault(matcher_fault),
.mapping_fault(mapping_fault),
.matched_count(matched_count),
.matcher_active(matcher_active),
.matcher_done(matcher_done),
.external_fault(external_fault || owner_fault),
.session_can_retire(session_can_retire),
.fault_latched(fault_latched),
.record_active(record_active),
.record_valid(record_valid),
.aux_pending(aux_pending),
.retired_take(retired_take),
.raw_count(raw_count),
.terminal_reason(terminal_reason),
.retire_count(retire_count),
.evidence_epoch(evidence_epoch),
.tick(tick),
.main_awaddr(main_awaddr),
.main_awvalid(main_awvalid),
.main_awready(main_awready),
.main_wdata(main_wdata),
.main_wstrb(main_wstrb),
.main_wvalid(main_wvalid),
.main_wready(main_wready),
.main_bresp(main_bresp),
.main_bvalid(main_bvalid),
.main_bready(main_bready),
.main_araddr(main_araddr),
.main_arvalid(main_arvalid),
.main_arready(main_arready),
.main_rdata(main_rdata),
.main_rresp(main_rresp),
.main_rvalid(main_rvalid),
.main_rready(main_rready),
.aux_awaddr(aux_awaddr),
.aux_awvalid(aux_awvalid),
.aux_awready(aux_awready),
.aux_wdata(aux_wdata),
.aux_wstrb(aux_wstrb),
.aux_wvalid(aux_wvalid),
.aux_wready(aux_wready),
.aux_bresp(aux_bresp),
.aux_bvalid(aux_bvalid),
.aux_bready(aux_bready),
.aux_araddr(aux_araddr),
.aux_arvalid(aux_arvalid),
.aux_arready(aux_arready),
.aux_rdata(aux_rdata),
.aux_rresp(aux_rresp),
.aux_rvalid(aux_rvalid),
.aux_rready(aux_rready),
.ctrl_awaddr(ctrl_awaddr),
.ctrl_awvalid(ctrl_awvalid),
.ctrl_awready(ctrl_awready),
.ctrl_wdata(ctrl_wdata),
.ctrl_wstrb(ctrl_wstrb),
.ctrl_wvalid(ctrl_wvalid),
.ctrl_wready(ctrl_wready),
.ctrl_bresp(ctrl_bresp),
.ctrl_bvalid(ctrl_bvalid),
.ctrl_bready(ctrl_bready),
.ctrl_araddr(ctrl_araddr),
.ctrl_arvalid(ctrl_arvalid),
.ctrl_arready(ctrl_arready),
.ctrl_rdata(ctrl_rdata),
.ctrl_rresp(ctrl_rresp),
.ctrl_rvalid(ctrl_rvalid),
.ctrl_rready(ctrl_rready),
.h1_awaddr(h1_awaddr),
.h1_awvalid(h1_awvalid),
.h1_awready(h1_awready),
.h1_wdata(h1_wdata),
.h1_wstrb(h1_wstrb),
.h1_wvalid(h1_wvalid),
.h1_wready(h1_wready),
.h1_bresp(h1_bresp),
.h1_bvalid(h1_bvalid),
.h1_bready(h1_bready),
.h1_araddr(h1_araddr),
.h1_arvalid(h1_arvalid),
.h1_arready(h1_arready),
.h1_rdata(h1_rdata),
.h1_rresp(h1_rresp),
.h1_rvalid(h1_rvalid),
.h1_rready(h1_rready));
 h1_7020_ch1_mapping_axi_v0_1 owner(
.clk(clk),
.rst_n(rst_n),
.external_fault(external_fault || matcher_fault || mapping_fault),
.runtime_busy(record_active || matcher_active || actual_arm),
.status_pending(status_backlog),
.evidence_epoch(evidence_epoch),
.consume(actual_arm),
.consume_epoch(evidence_epoch),
.consume_record_id(actual_record_id),
.consume_identity(actual_identity),
.retired(retired_take),
.retired_epoch(actual_retired_epoch),
.retired_record_id(actual_retired_record_id),
.retired_identity(actual_retired_identity),
.mapping_valid(mapping_valid),
.mapping_epoch(mapping_epoch),
.mapping_peer_epoch(mapping_peer_epoch),
.mapping_record_id(mapping_record_id),
.mapping_identity(mapping_identity),
.mapping_inner_crc(mapping_inner_crc),
.fault_latched(owner_fault),
.first_fault(),
.s_axi_awaddr(map_awaddr),
.s_axi_awvalid(map_awvalid),
.s_axi_awready(map_awready),
.s_axi_wdata(map_wdata),
.s_axi_wstrb(map_wstrb),
.s_axi_wvalid(map_wvalid),
.s_axi_wready(map_wready),
.s_axi_bresp(map_bresp),
.s_axi_bvalid(map_bvalid),
.s_axi_bready(map_bready),
.s_axi_araddr(map_araddr),
.s_axi_arvalid(map_arvalid),
.s_axi_arready(map_arready),
.s_axi_rdata(map_rdata),
.s_axi_rresp(map_rresp),
.s_axi_rvalid(map_rvalid),
.s_axi_rready(map_rready));
endmodule
