caoc30255-eng/glitchscope/src/pl/ax7020/rtl/h1_7020_ch0_uart_registration_top_v0_2.v

`timescale 1ns/1ps
// 100MHz/1Mbps isolated serial frontend + HRP1 + accepted H0R1. No PS/BD.
module h1_7020_ch0_uart_registration_top_v0_2(

 input wire clk,rst_n,external_fault,
 input wire ch0_async,
 input wire [31:0] evidence_epoch,
 output wire registered_ready,
 output wire active,closed,fault_latched,
 output wire [7:0] first_fault,
 output wire [31:0] bound_epoch,bound_id,
 output wire [255:0] bound_identity,
 output wire [63:0] tick,start_tick,deadline_tick,
 input wire [14:0] s_axi_awaddr,
 input wire s_axi_awvalid,
 output wire s_axi_awready,
 input wire [31:0] s_axi_wdata,
 input wire [3:0] s_axi_wstrb,
 input wire s_axi_wvalid,
 output wire s_axi_wready,
 output wire [1:0] s_axi_bresp,
 output wire s_axi_bvalid,
 input wire s_axi_bready,
 input wire [14:0] s_axi_araddr,
 input wire s_axi_arvalid,
 output wire s_axi_arready,
 output wire [31:0] s_axi_rdata,
 output wire [1:0] s_axi_rresp,
 output wire s_axi_rvalid,
 input wire s_axi_rready
,
 input wire [7:0] p_axi_awaddr,
 input wire p_axi_awvalid,output wire p_axi_awready,
 input wire [31:0] p_axi_wdata,input wire [3:0] p_axi_wstrb,
 input wire p_axi_wvalid,output wire p_axi_wready,
 output wire [1:0] p_axi_bresp,output wire p_axi_bvalid,input wire p_axi_bready,
 input wire [7:0] p_axi_araddr,input wire p_axi_arvalid,output wire p_axi_arready,
 output wire [31:0] p_axi_rdata,output wire [1:0] p_axi_rresp,
 output wire p_axi_rvalid,input wire p_axi_rready

, output wire paths_ready,profile_fault,a_event,b_event,a_fe,b_fe,
 output wire [7:0] a_byte,b_byte,
 output wire a_idle,b_idle
);
 wire rx_sync,rx_ce;
 wire [2:0] applied_d;
 wire signed [3:0] applied_s;
 // Original framing_error is held until the next result; qualify it with rx_valid.
 wire combined_fault=external_fault || profile_fault || (active && closed && (!a_idle || !b_idle));
 uart_rx_frontend_7020_v2_2 frontend(.clk(clk),.rst_n(rst_n),.ref_rx_i(ch0_async),.ref_rx_sync(rx_sync));
 rx_ce_gen_7020_v2_2 ce(.clk(clk),.rst_n(rst_n),.rx_ce(rx_ce));
 uart_rx_a_7020_observe_v0_1 #(.INPUT_ALREADY_SYNCED(1)) receiver_a(
 .clk(clk),.rst_n(rst_n),.rx_ce(rx_ce),.uart_rx(rx_sync),.rx_byte(a_byte),.rx_valid(a_event),.framing_error(a_fe),.rx_idle(a_idle));
 uart_rx_b_7020_observe_v0_1 #(.INPUT_ALREADY_SYNCED(1)) receiver_b(
 .clk(clk),.rst_n(rst_n),.rx_ce(rx_ce),.uart_rx(rx_sync),.cfg_d(applied_d),.cfg_s(applied_s),.rx_byte(b_byte),.rx_valid(b_event),.framing_error(b_fe),.rx_idle(b_idle));
h1_7020_ch0_rx_profile_axi_v0_1 profile(
.clk(clk),
.rst_n(rst_n),
.external_fault(external_fault),
.rx_sync(rx_sync),
.a_idle(a_idle),
.b_idle(b_idle),
.capture_active(active),
.capture_closed(closed),
.tick(tick),
.a_event(a_event),
.b_event(b_event),
.a_fe(a_fe),
.b_fe(b_fe),
.a_byte(a_byte),
.b_byte(b_byte),
.active_d(applied_d),
.active_s(applied_s),
.paths_ready(paths_ready),
.profile_fault(profile_fault),
.p_axi_awaddr(p_axi_awaddr),
.p_axi_awvalid(p_axi_awvalid),
.p_axi_awready(p_axi_awready),
.p_axi_wdata(p_axi_wdata),
.p_axi_wstrb(p_axi_wstrb),
.p_axi_wvalid(p_axi_wvalid),
.p_axi_wready(p_axi_wready),
.p_axi_bresp(p_axi_bresp),
.p_axi_bvalid(p_axi_bvalid),
.p_axi_bready(p_axi_bready),
.p_axi_araddr(p_axi_araddr),
.p_axi_arvalid(p_axi_arvalid),
.p_axi_arready(p_axi_arready),
.p_axi_rdata(p_axi_rdata),
.p_axi_rresp(p_axi_rresp),
.p_axi_rvalid(p_axi_rvalid),
.p_axi_rready(p_axi_rready));
h1_7020_ch0_frame_registration_axi_v0_2 capture(
.clk(clk),
.rst_n(rst_n),
.external_fault(combined_fault),
.a_path_ready(paths_ready),
.b_path_ready(paths_ready),
.evidence_epoch(evidence_epoch),
.a_valid(a_event),
.b_valid(b_event),
.a_error(a_event && a_fe),
.b_error(b_event && b_fe),
.a_data(a_byte),
.b_data(b_byte),
.a_flags({2'd0,a_fe,1'd0}),
.b_flags({2'd0,b_fe,1'd0}),
.registered_ready(registered_ready),
.active(active),
.closed(closed),
.fault_latched(fault_latched),
.first_fault(first_fault),
.bound_epoch(bound_epoch),
.bound_id(bound_id),
.bound_identity(bound_identity),
.tick(tick),
.start_tick(start_tick),
.deadline_tick(deadline_tick),
.s_axi_awaddr(s_axi_awaddr),
.s_axi_awvalid(s_axi_awvalid),
.s_axi_awready(s_axi_awready),
.s_axi_wdata(s_axi_wdata),
.s_axi_wstrb(s_axi_wstrb),
.s_axi_wvalid(s_axi_wvalid),
.s_axi_wready(s_axi_wready),
.s_axi_bresp(s_axi_bresp),
.s_axi_bvalid(s_axi_bvalid),
.s_axi_bready(s_axi_bready),
.s_axi_araddr(s_axi_araddr),
.s_axi_arvalid(s_axi_arvalid),
.s_axi_arready(s_axi_arready),
.s_axi_rdata(s_axi_rdata),
.s_axi_rresp(s_axi_rresp),
.s_axi_rvalid(s_axi_rvalid),
.s_axi_rready(s_axi_rready));
endmodule
