caoc30255-eng/glitchscope/src/pl/ax7020/rtl/uart_rx_a_7020_observe_v0_1.v

`timescale 1ns / 1ps

// ============================================================
// RefDUT Receiver A
//
// UART:
//   1 Mbps nominal
//   8N1
//   LSB first
//
// Clock:
//   100 MHz
//
// rx_ce:
//   16x clock enable
//   generated externally
//
// Start timing:
//
//   first sampled LOW = n = 0
//
//   start confirm:
//       m = 2
//
//   start center:
//       n = 8
//
// Data centers:
//
//   D0 = 24
//   D1 = 40
//   D2 = 56
//   D3 = 72
//   D4 = 88
//   D5 = 104
//   D6 = 120
//   D7 = 136
//
// Stop center:
//
//   n = 152
//
// Receiver A:
//
//   single-point sampling.
//
// IMPORTANT:
//
//   rx_valid is generated on the NEXT 100 MHz clock
//   after the stop-bit sample.
//
// ------------------------------------------------------------
// V1.2 common-frontend compatibility:
//
// INPUT_ALREADY_SYNCED = 0
//     Legacy mode.
//     uart_rx is asynchronous/raw.
//     Use Receiver A internal two-stage synchronizer.
//
// INPUT_ALREADY_SYNCED = 1
//     Final Top mode.
//     uart_rx already comes from shared uart_rx_frontend.
//     Internal synchronizer is bypassed.
//
// The default remains 0 so all previous testbenches continue
// to use exactly the legacy input path.
// ============================================================

module uart_rx_a_7020_observe_v0_1
#(
    parameter INPUT_ALREADY_SYNCED = 0
)
(
    input  wire       clk,
    input  wire       rst_n,

    input  wire       rx_ce,

    input  wire       uart_rx,

    output reg [7:0]  rx_byte,
    output reg        rx_valid,
    output reg        framing_error,
    output wire rx_idle
);


    // ========================================================
    // Legacy internal input synchronizer
    //
    // Still physically exists for backward-compatible tests.
    //
    // In final Top:
    //
    // INPUT_ALREADY_SYNCED = 1
    //
    // and rx_input_used directly uses uart_rx, which is already
    // the output of the shared two-stage frontend.
    // ========================================================

    reg rx_sync1;
    reg rx_sync2;


    always @(posedge clk)
    begin

        if (!rst_n)
        begin

            rx_sync1 <= 1'b1;
            rx_sync2 <= 1'b1;

        end

        else
        begin

            rx_sync1 <= uart_rx;
            rx_sync2 <= rx_sync1;

        end

    end
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
