caoc30255-eng/glitchscope/(notices)

Notices in the files:
README.md:
License: MIT
